smartbench/mainboard/fabrication_outputs/iCE40hxk4_dev_board.csv

Reference | Quantity | Identifier | Package | Value | Tolerance | Voltage | Current | Power | PN | MPN | Dielectric | Type | VDC | Current Max. | Irange | Vref | Impedance 100MHz | If | Vf | Datashet
R101;R704;R708;R1108;R1110;R1107;R1109;R1106;R1105;R207;R201;R209;R210;R301;R302;R303;R304;R305;R306 | 19 |  |  | 10K |  |  |  |  |  | RT0603DRE0710KL
J101;J601;J602 | 3 |  |  | CONN_01X02
J104;J103 | 2 |  |  | CONN_COAXIAL |  |  |  |  |  | 73100-0105
J102 | 1 |  |  | KobiConn_161-3507_Jack_3.5mm |  |  |  |  |  | KobiConn_161-3507
U301 | 1 |  |  | iCE40-HX4K-TQ144 |  |  |  |  |  | iCE40-HX4K-TQ144
C510;C509;C502;C501;C503;C504;C505;C506;C507;C508;C608;C601;C603;C606;C612;C614;C616;C619;C621;C623;C625;C627;C629;C631;C633;C635;C605;C618;C905;C1003;C1011;C1005;C1006;C1002;C1010;C1018;C1102;C1101;C401;C402;C403;C404;C405;C407;C206;C204;C208;C216;C217;C218;C219;C220;C221;C222;C223;C224;C201;C209;C313;C305;C307;C309;C311;C308;C314;C316;C301 | 67 |  |  | 100nF |  |  |  |  |  | C0603C104K3RACTU | X7R | Ceramic | 25V
U501 | 1 |  |  | AS4C1M16S |  |  |  |  |  | AS4C1M16S
C620;C610;C901;C902 | 4 |  |  | 10uF |  |  |  |  |  | GRM188R60J106ME47J | X5R | Ceramic | 6V3
C602;C604;C607;C609;C611;C613;C615;C617;C622;C624;C626;C628;C630;C632;C634;C636;C906;C904;C903;C303;C306 | 21 |  |  | 1uF |  |  |  |  |  | GRM188R61C105KA93D | X5R | Ceramic | 16V
Xtal401;Xtal201 | 2 |  |  | LFSPXO019966 |  |  |  |  |  | LFSPXO019966
SW1101 | 1 |  |  | SW_Push
J1101 | 1 |  |  | CONN_01X25
C907;C1012;C1004;C1008;C1007;C1001;C1009;C1013;C1014;C1015;C1017;C1016;C315;C302;C304;C317 | 16 |  |  | 10uF |  |  |  |  |  | TAJA106K016TNJ |  | Tantalum | 16V
U903 | 1 |  |  | MIC5270 |  |  |  |  |  | MIC5270
U902 | 1 |  |  | TCR2EF13 |  |  |  |  |  | TCR2EF13
U901 | 1 |  |  | LM2776DBVR |  |  |  |  |  | LM2776DBVR
C213;C215;C207;C205 | 4 |  |  | 4.7uF |  |  |  |  |  | TAJA475K016UNJ |  | Tantalum | 16V |  |  |  |  |  |  | http://www.mouser.com/ds/2/40/TAJ_AUTO-783622-1093304.pdf
R211 | 1 |  |  | 12K |  |  |  |  |  | RC0603FR-0712KL
U204 | 1 |  |  | MIC5355/6-xYMME |  |  |  |  |  | MIC5355/6-xYMME
U203 | 1 |  |  | 93LC56BT-I/O |  |  |  |  |  | 93LC56BT-I/O
U201 | 1 |  |  | MIC2005A-2YM5 |  |  |  |  |  | MIC2005A-2YM5
D401;D402;D403;D404;D405;D406;D407;D408;D202;D204 | 10 |  |  | GREEN |  |  |  |  |  | APTD1608LCGCK |  |  |  |  |  |  |  | 2mA | 1.9V
C202;C203;C312;C310 | 4 |  |  | 10nF |  |  |  |  |  | C0603C103K5RECTU | X7R |  | 50V
U1002;U1001 | 2 |  |  | ADC1175 |  |  |  |  |  | ADC1175CIMTCX/NOPB
D1005;D1004 | 2 |  |  | D_Schottky_BAT54-7-F |  |  |  |  |  | BAT54-7-F
C211;C212;C210 | 3 |  |  | 2.2uF |  |  |  |  |  | GRM21BR71A225KA01K | X7R | Ceramic | 10V
R401;R402;R403;R404;R405;R406;R407;R408 | 8 |  |  | 680R |  |  |  |  |  | RC0603FR-07680RL
D1002 | 1 |  |  | LM4041EIM3-1.2/NOPB |  |  |  |  |  | LM4041EIM3-1.2/NOPB |  |  |  |  | ?mA < I < ?mA | 1.225V
D1001;D1003 | 2 |  |  | LM4040DYM3-2.5-TR |  |  |  |  |  | LM4040DYM3-2.5-TR |  |  |  |  | 65uA < I < 15mA | 2.5V
R1004;R1001 | 2 |  |  | 50R |  |  |  |  |  | CRCW060350R0FKEA
R1008;R1009;R1006;R1007;R1113;R1116 | 6 |  |  | 4K7 |  |  |  |  |  | RC0603FR-074K7L
L1002;L1001;L1003;L1004;L1005;L1007;L1006 | 7 |  |  | L_BLM18AG121SN1D |  |  |  |  |  | BLM18AG121SN1D |  |  |  |  |  |  | 75
R1112;R1111 | 2 |  |  | 330R |  |  |  |  |  | RC0603FR-07330RL
R309;R310;R311;R312;R313;R314;R315;R316;R317;R318;R319;R320;R321;R322;R827;R830;R1118;R1115;R212 | 19 |  |  | 1K |  |  |  |  |  | RC0603FR-071KL
R1114;R1117 | 2 |  |  | 1K2 |  |  |  |  |  | RC0603FR-071K2L
L201;L204;L203;L202 | 4 |  |  | L_BLM18BA750SZ1D |  |  |  |  |  | BLM18AG121SN1D |  |  |  |  |  |  | 75
C703;C706 | 2 |  |  | 22pF |  |  |  |  |  | 06031U220FAT2A | C0G | Ceramic | 100V
C705;C708 | 2 |  |  | 5-20pF |  |  |  |  |  | GKG20015
R701;R705 | 2 |  |  | 13K |  |  |  |  |  | RC0603FR-0713KL
R703;R707 | 2 |  |  | 89K8 |  |  |  |  |  | RT0603DRE0789K8L
C701;C702 | 2 |  |  | 100pF |  |  |  |  |  | VJ0603A101JXACW1BC | C0G | Ceramic | 50V
C704;C707 | 2 |  |  | 1-3pF |  |  |  |  |  | GKG3R015
C709;C711 | 2 |  |  | 180p |  |  |  |  |  | VJ0603A181FXXPW1BC | C0G | Ceramic | 25V
C710;C712 | 2 |  |  | 1800p |  |  |  |  |  | GCM1885C1H182FA16D | C0G | Ceramic | 50V
D701;D702;D1007;D1006 | 4 |  |  | D_Schottky_BAT54S-7-F |  |  |  |  |  | BAT54S-7-F
U702;U701 | 2 |  |  | CPC1017N |  |  |  |  |  | CPC1017N
U703;U704;U801;U802 | 4 |  |  | CD4051BM96 |  |  |  |  |  | CD4051BM96
R702;R706 | 2 |  |  | 887K |  |  |  |  |  | RC0603FR-07887KL
R802;R804;R1101;R1102 | 4 |  |  | Let it open
D203 | 1 |  |  | RED |  |  |  |  |  | APTD1608LSURCK |  |  |  |  |  |  |  | 2mA | 1.75V
R202;R205;R204 | 3 |  |  | 1K5 |  |  |  |  |  | CRCW06031K50JNEA
U302 | 1 |  |  | 25LC_EEPROM |  |  |  |  |  | 25LC_EEPROM
U1106;U1101;U1105;U1102 | 4 |  |  | MIC7300 |  |  |  |  |  | MIC7300YM5-TR
U1104 | 1 |  |  | MCP4716 |  |  |  |  |  | MCP4716A0-E/CH
U205 | 1 |  |  | FT2232H |  |  |  |  |  | FT2232H
R710;R709;R803;R801;R1002;R1005;R1103;R1104;R213;R214;R215;R216;R217;R218;R219;R220;R221;R222;R223;R224;R225;R226;R227;R228;R229;R230;R231 | 27 |  |  | 0R |  |  |  |  |  | RC1206JR-070RL |  |  |  | 2A
C714;C713;R833;R837;R834;R838;R835;R839;R836;R840 | 10 |  |  | Not used
R1121;R1122 | 2 |  |  | 62K |  |  |  |  |  | RC0603FR-0762KL
R1119;R1120 | 2 |  |  | 6K8 |  |  |  |  |  | RC0603FR-076K8L
J1005 | 1 |  |  | USB_EXT
C214 | 1 |  |  | 4.7uF |  |  |  |  |  | GRM21BR71C475KE51L | X7R | Ceramic | 16V
J405;J406;J402;J401;J404;J403;J502;J501;J603;J605;J604;J706;J705;J703;J704;J701;J702;J808;J807;J805;J806;J804;J803;J802;J801;J810;J809;J1001;J1002;J1003;J1004 | 31 |  |  | Testpoint
U1103 | 1 |  |  | MCP4716 |  |  |  |  |  | MCP4716A1-E/CH
D301 | 1 |  |  | D_BAS21,215 |  |  |  |  |  | BAS21,215
U803 | 1 |  |  | CLC4007 |  |  |  |  |  | CLC4007
R805;R806;R807;R808;R1011;R1010 | 6 |  |  | 470R |  |  |  |  |  | RC0603FR-07470RL
R811;R815;R817;R812;R818;R820;R1013;R1012;R1003 | 9 |  |  | 220R |  |  |  |  |  | RC0603JR-07220RL
R821;R823;R824;R826;R307;R308 | 6 |  |  | 100R |  |  |  |  |  | RC0603FR-07100RL
R809;R813;R816;R822;R810;R814;R819;R825 | 8 |  |  | 1K8 |  |  |  |  |  | RC0603FR-071K8L
R828;R831 | 2 |  |  | 47K |  |  |  |  |  | RC0603FR-0747KL
R829;R832;R208 | 3 |  |  | 2K2 |  |  |  |  |  | RC0603FR-072K2L
D201;D208 | 2 |  |  | D_Schottky_CDBURT0530LL-HF |  |  |  |  |  | CDBURT0530LL-HF
J202 | 1 |  |  | USB_OTG
