smartbench/mainboard/fabrication_outputs/iCE40hxk4_dev_board.xlsx

 |  |  |  |  |  |  | Board Qty: | 5
 |  |  |  |  |  |  | Total Cost: | $265.44 |  |  |  | $333.19 |  |  |  |  |  | $164.89 |  |  |  |  |  | $337.89 |  |  |  |  |  | $194.54 |  |  |  |  |  | $727.60
 |  |  |  |  |  |  | Unit Cost: | $53.09
Global Part Info |  |  |  |  |  |  |  |  | Digi-Key |  |  |  |  |  | Farnell |  |  |  |  |  | Mouser |  |  |  |  |  | Newark |  |  |  |  |  | Rs Components
Refs | Value | Desc | Footprint | Manf | Manf# | Qty | Unit$ | Ext$ | Avail | Purch | Unit$ | Ext$ | Cat# | Doc | Avail | Purch | Unit$ | Ext$ | Cat# | Doc | Avail | Purch | Unit$ | Ext$ | Cat# | Doc | Avail | Purch | Unit$ | Ext$ | Cat# | Doc | Avail | Purch | Unit$ | Ext$ | Cat# | Doc
R213-R231 | 0R |  | Resistors_SMD:R_0603_HandSoldering |  | RC1206JR-070RL | 95 | $0.01 | $1.25 | 8491390 |  | $0.01 | $1.25 | 311-0.0ERCT-ND | Link (http://www.digikey.com/product-detail/en/yageo/RC1206JR-070RL/311-0.0ERCT-ND/732131) |  |  | $0.01 | $1.38 | 9240276 | Link (http://it.farnell.com/yageo-phycomp/rc1206jr-070rl/res-film-spesso-0r-5-0-25w-1206/dp/9240276) | 1140411 |  | $0.02 | $1.71 | 603-RC1206JR-070RL | Link (http://www.mouser.com/Search/Refine.aspx?Keyword=RC1206JR-070RL%20) |  |  | $0.02 | $1.52 | 68R0297 | Link (http://www.newark.com/yageo/rc1206jr-070rl/res-thick-film-0r-0-25w-1206/dp/68R0297)
R828,R831 | 47K |  | Resistors_SMD:R_0603_HandSoldering |  | RC0603FR-0747KL | 10 | $0.01 | $0.09 | 3662752 |  | $0.01 | $0.15 | 311-47.0KHRCT-ND | Link (http://www.digikey.com/product-detail/en/yageo/RC0603FR-0747KL/311-47.0KHRCT-ND/730200) |  |  | $0.01 | $0.09 | 9238689 | Link (http://it.farnell.com/yageo-phycomp/rc0603fr-0747kl/res-film-spesso-47k-1-0-1w-0603/dp/9238689) | 379387 |  | $0.01 | $0.11 | 603-RC0603FR-0747KL | Link (http://www.mouser.com/Search/Refine.aspx?Keyword=RC0603FR-0747KL%20) |  |  | $0.01 | $0.11 | 26M6759 | Link (http://www.newark.com/yageo-phycomp/rc0603fr-0747kl/res-thick-film-47k-1-0-1w-0603/dp/26M6759)
C601,C603,C605,C606,C608,C612,C614,C616,C618,C619,C621,C623,C625,C627,C629,C631,C633,C635,C905,C1002,C1003,C1005,C1006,C1010,C1011,C1018,C1101,C1102 | 100nF |  | Capacitors_SMD:C_0603_HandSoldering |  | C0603C104K3RACTU | 140 | $0.01 | $1.82 | 4778400 |  | $0.01 | $1.90 | 399-1281-1-ND | Link (http://www.digikey.com/product-detail/en/kemet/C0603C104K3RACTU/399-1281-1-ND/416057) |  |  | $0.02 | $2.44 | 1650835 | Link (http://it.farnell.com/kemet/c0603c104k3ractu/condensatore-mlcc-x7r-100nf-25v/dp/1650835) | 492157 |  | $0.01 | $1.82 | 80-C0603C104K3R | Link (http://www.mouser.com/ProductDetail/KEMET/C0603C104K3RACTU/?qs=sGAEpiMZZMs0AnBnWHyRQFqPnX0Olvco4w4aWMbN5gs%3D) |  |  | $0.01 | $1.82 | 64K2837 | Link (http://www.newark.com/kemet/c0603c104k3ractu/ceramic-capacitor-0-1uf-25v-x7r/dp/64K2837) | 2500 |  | $0.02 | $2.53 | 147-538 | Link (http://it.rs-online.com/web/c/?searchTerm=C0603C104K3RACTU%20)
R1111,R1112 | 330R |  | Resistors_SMD:R_0603_HandSoldering |  | RC0603FR-07330RL | 10 | $0.002 | $0.02 | 1578144 |  | $0.01 | $0.15 | 311-330HRCT-ND | Link (http://www.digikey.com/product-detail/en/yageo/RC0603FR-07330RL/311-330HRCT-ND/730109) |  |  | $0.01 | $0.08 | 9238425 | Link (http://it.farnell.com/yageo-phycomp/rc0603fr-07330rl/res-film-spesso-330r-1-0-1w-0603/dp/9238425) | 187203 |  | $0.01 | $0.11 | 603-RC0603FR-07330RL | Link (http://www.mouser.com/Search/Refine.aspx?Keyword=RC0603FR-07330RL%20) |  |  | $0.002 | $0.02 | 75X0150 | Link (http://www.newark.com/yageo-phycomp/rc0603fr-07330rl/surface-mount-chip-resistor-thick/dp/75X0150)
U205 | FT2232H |  | Housings_QFP:LQFP-64_10x10mm_Pitch0.5mm |  | FT2232HL | 5 | $6.24 | $31.20 | 35362 |  | $6.71 | $33.55 | 768-1024-1-ND | Link (http://www.digikey.com/product-detail/en/ftdi-future-technology-devices-international-ltd/FT2232HL-REEL/768-1024-1-ND/1986057) |  |  | $7.31 | $36.57 | 1697461 | Link (http://it.farnell.com/ftdi/ft2232hl-r/usb-uart-fifo-2232-doppio-64lqfp/dp/1697461) | 1526 |  | $6.73 | $33.65 | 895-FT2232HL-TRAY | Link (http://www.mouser.com/ProductDetail/FTDI/FT2232HL-TRAY/?qs=sGAEpiMZZMsgaWLkU6GBSK8bHXjqNrK1) |  |  | $7.74 | $38.70 | 80P4235 | Link (http://www.newark.com/webapp/wcs/stores/servlet/Search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) | 25 |  | $6.24 | $31.20 | 687-7720 | Link (http://it.rs-online.com/web/c/?searchTerm=FT2232HL%20)
C610,C620,C901,C902 | 10uF |  | Capacitors_SMD:C_0603_HandSoldering |  | GRM188R60J106ME47J | 20 | $0.05 | $1.08 |  |  | $0.12 | $2.46 | 490-6405-1-ND | Link (http://www.digikey.com/product-detail/en/murata-electronics-north-america/GRM188R60J106ME47J/490-6405-1-ND/3845602) |  |  | $0.07 | $1.35 | 2611921 | Link (http://it.farnell.com/murata/grm188r60j106me47j/cond-mlcc-x5r-10uf-6-3v-0603/dp/2611921) | 36345 |  | $0.10 | $2.10 | 81-GRM188R60J106ME7J | Link (http://www.mouser.com/Search/Refine.aspx?Keyword=GRM188R60J106ME47J%20) |  |  | $0.10 | $2.10 | 96Y9254 | Link (http://www.newark.com/webapp/wcs/stores/servlet/Search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) | 1000 |  | $0.05 | $1.08 | 815-1355 | Link (http://it.rs-online.com/web/c/?searchTerm=GRM188R60J106ME47J%20)
R202,R204,R205 | 1K5 |  | Resistors_SMD:R_0603_HandSoldering |  | CRCW06031K50JNEA | 15 | $0.02 | $0.31 |  |  | $0.03 | $0.39 | 541-1.5KGCT-ND | Link (http://www.digikey.com/product-detail/en/vishay-dale/CRCW06031K50JNEA/541-1.5KGCT-ND/1179373) |  |  | $0.02 | $0.31 | 2616745 | Link (http://it.farnell.com/vishay/crcw06031k50jnea/res-pell-spessa-aec-q200-1k5-0603/dp/2616745) | 213515 |  | $0.04 | $0.60 | 71-CRCW0603J-1.5K-E3 | Link (http://www.mouser.com/ProductDetail/Vishay/CRCW06031K50JNEA/?qs=sGAEpiMZZMu61qfTUdNhG82Z6Ry1C7AqqcTNlUx7YuQ%3D) |  |  | $0.10 | $1.50 | 59M6753 | Link (http://www.newark.com/vishay/crcw06031k50jnea/res-thick-film-1k5-5-0-1w-0603/dp/59M6753) |  |  |  |  | 830-6668 | Link (http://it.rs-online.com/web/c/?searchTerm=CRCW06031K50JNEA%20)
D1001,D1003 | LM4040DYM3-2.5-TR |  | TO_SOT_Packages_SMD:SOT-23 |  | LM4040DYM3-2.5-TR | 10 | $0.21 | $2.09 | 14820 |  | $0.30 | $3.00 | 576-1047-1-ND | Link (http://www.digikey.com/product-detail/en/microchip-technology/LM4040DYM3-2.5-TR/576-1047-1-ND/771818) |  |  | $0.21 | $2.09 | 2509865 | Link (http://it.farnell.com/microchip/lm4040dym3-2-5-tr/voltage-ref-shunt-2-5v-sot-23/dp/2509865) | 5263 |  | $0.29 | $2.91 | 998-LM4040DYM3-2.5TR | Link (http://www.mouser.com/Search/Refine.aspx?Keyword=LM4040DYM3-2.5-TR%20) |  |  | $0.30 | $3.03 | 91Y4892 | Link (http://www.newark.com/webapp/wcs/stores/servlet/Search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)
R1119,R1120 | 6K8 |  | Resistors_SMD:R_0603_HandSoldering |  | RC0603FR-076K8L | 10 | $0.01 | $0.09 | 1237938 |  | $0.01 | $0.15 | 311-6.80KHRCT-ND | Link (http://www.digikey.com/product-detail/en/yageo/RC0603FR-076K8L/311-6.80KHRCT-ND/730270) |  |  | $0.01 | $0.09 | 9238581 | Link (http://it.farnell.com/yageo-phycomp/rc0603fr-076k8l/res-film-spesso-6k8-1-0-1w-0603/dp/9238581) | 207781 |  | $0.01 | $0.11 | 603-RC0603FR-076K8L | Link (http://www.mouser.com/Search/Refine.aspx?Keyword=RC0603FR-076K8L%20) |  |  | $0.01 | $0.14 | 68R0109 | Link (http://www.newark.com/yageo/rc0603fr-076k8l/res-thick-film-6k8-1-0-1w-0603/dp/68R0109)
U201 | MIC2005A-2YM5 |  | TO_SOT_Packages_SMD:SOT-23-5_HandSoldering |  | MIC2005A-2YM5 | 5 | $0.21 | $1.05 | 4176 |  | $0.29 | $1.45 | 576-3464-1-ND | Link (http://www.digikey.com/product-detail/en/microchip-technology/MIC2005A-2YM5-TR/576-3464-1-ND/2062464) |  |  | $0.21 | $1.05 | 2431853 | Link (http://it.farnell.com/micrel-semiconductor/mic2005a-2ym5-tr/limitaz-corrente-attiva-alta-e/dp/2431853) | 3448 |  | $0.30 | $1.50 | 998-MIC2005A-2YM5TR | Link (http://www.mouser.com/Search/Refine.aspx?Keyword=MIC2005A-2YM5%20) |  |  | $0.22 | $1.08 | 11AC9662 | Link (http://www.newark.com/webapp/wcs/stores/servlet/Search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) | 640 |  | $0.30 | $1.49 | 727-5113 | Link (http://it.rs-online.com/web/c/?searchTerm=MIC2005A-2YM5%20)
C704,C707 | 1-3pF |  | Capacitors_THT:CP_Radial_Tantal_D6.0mm_P5.00mm |  | GKG3R015 | 10 | $0.66 | $6.55 | 1423 |  | $0.66 | $6.55 | SG9031-ND | Link (http://www.digikey.com/scripts/DkSearch/dksus.dll?WT.z_header=search_go&lang=en&keywords=GKG3R015%20) |  |  |  |  |  |  | 113 |  | $0.77 | $7.65 | 659-GKG3R015 | Link (http://www.mouser.com/Search/Refine.aspx?Keyword=GKG3R015%20)
C701,C702 | 100pF |  | Capacitors_SMD:C_0603_HandSoldering |  | GRM1885C1H101GA01J | 10 | $0.05 | $0.52 | 24146 |  | $0.10 | $1.05 | 490-10703-1-ND | Link (http://www.digikey.com/product-detail/en/murata-electronics-north-america/GRM1885C1H101GA01J/490-10703-1-ND/5251397) |  |  |  |  |  |  | 14678 |  | $0.05 | $0.52 | 81-GRM1885C1H101GA1J | Link (http://www.mouser.com/Search/Refine.aspx?Keyword=GRM1885C1H101GA01J%20)
L1001-L1007 | L_BLM18AG121SN1D |  | Inductors_SMD:L_0603_HandSoldering |  | BLM18AG121SN1D | 35 | $0.03 | $1.12 | 595822 |  | $0.07 | $2.52 | 490-1011-1-ND | Link (http://www.digikey.com/product-detail/en/murata-electronics-north-america/BLM18AG121SN1D/490-1011-1-ND/584459) |  |  | $0.03 | $1.12 | 1515672 | Link (http://it.farnell.com/murata/blm18ag121sn1d/ferrite-bead-0-18ohm-500ma-0603/dp/1515672) | 111537 |  | $0.06 | $2.24 | 81-BLM11A121S | Link (http://www.mouser.com/Search/Refine.aspx?Keyword=BLM18AG121SN1D%20) |  |  | $0.05 | $1.89 | 73M9051 | Link (http://www.newark.com/webapp/wcs/stores/servlet/Search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) | 720 |  | $0.08 | $2.68 | 202-3550 | Link (http://it.rs-online.com/web/c/?searchTerm=BLM18AG121SN1D%20)
C1001,C1004,C1007-C1009,C1012-C1017 | 10uF |  | Capacitors_SMD:C_1206_HandSoldering |  | TAJA106K016TNJ | 55 | $0.10 | $5.67 |  |  | $0.32 | $17.71 | 478-10744-1-ND | Link (http://www.digikey.com/product-detail/en/avx-corporation/TAJA106K016TNJ/478-10744-1-ND/7536607) |  |  |  |  |  |  | 1756 |  | $0.10 | $5.67 | 581-TAJA106K016TNJ | Link (http://www.mouser.com/Search/Refine.aspx?Keyword=TAJA106K016TNJ%20) |  |  | $0.20 | $10.78 | 60R5827 | Link (http://www.newark.com/avx/taja106k016rnj/tantalum-capacitor-10uf-16v-3/dp/60R5827?rpsku=rel3%3ATAJA106K016TNJ)
SW1101 | SW_Push |  | Buttons_Switches_THT:SW_PUSH_6mm_h4.3mm |  | 1301.9309 | 5 | $0.25 | $1.24 |  |  | $0.35 | $1.75 | 486-3464-ND | Link (http://www.digikey.com/scripts/DkSearch/dksus.dll?WT.z_header=search_go&lang=en) |  |  |  |  | 1217779 | Link (http://it.farnell.com/webapp/wcs/stores/servlet/Search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) | 1478 |  | $0.25 | $1.24 | 693-1301.9309 | Link (http://www.mouser.com/Search/Refine.aspx?Keyword=1301.9309%20) |  |  | $0.36 | $1.80 | 32C4748 | Link (http://www.newark.com/webapp/wcs/stores/servlet/Search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)
J103,J104 | CONN_COAXIAL |  | library:BNC_1-1337543-0 |  | 1-1337543-0 | 10 | $1.32 | $13.20 | 3053 |  | $1.65 | $16.54 | A97553-ND | Link (http://www.digikey.com/scripts/DkSearch/dksus.dll?WT.z_header=search_go&lang=en) |  |  | $1.50 | $14.99 | 1020955 | Link (http://it.farnell.com/webapp/wcs/stores/servlet/Search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) | 3595 |  | $1.73 | $17.30 | 571-1-1337543-0 | Link (http://www.mouser.com/Search/Refine.aspx?Keyword=1-1337543-0%20) |  |  | $1.32 | $13.20 | 63K9785 | Link (http://www.newark.com/webapp/wcs/stores/servlet/Search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) |  |  | $2.00 | $19.98 | 512-1225 | Link (http://it.rs-online.com/web/c/?searchTerm=1-1337543-0%20)
D1004,D1005 | D_Schottky_BAT54-7-F |  | Diodes_SMD:D_SOT-23_ANK |  | BAT54-7-F | 10 | $0.03 | $0.27 | 222415 |  | $0.15 | $1.49 | BAT54-FDICT-ND | Link (http://www.digikey.com/product-detail/en/diodes-incorporated/BAT54-7-F/BAT54-FDICT-ND/717819) |  |  | $0.03 | $0.27 | 2306003 | Link (http://it.farnell.com/multicomp/bat54-7-f/diode-ultrafast-recovery-200ma/dp/2306003) | 67684 |  | $0.14 | $1.43 | 621-BAT54-F | Link (http://www.mouser.com/Search/Refine.aspx?Keyword=BAT54-7-F%20) |  |  | $0.12 | $1.19 | 65W8455 | Link (http://www.newark.com/multicomp/bat54-7-f/diode-ultrafast-recovery-200ma/dp/65W8455) |  |  | $0.07 | $0.66 | 738-4829 | Link (http://it.rs-online.com/web/p/diodi-rettificatori-e-schottky/7384829/)
C205,C207,C213,C215 | 4.7uF |  | Capacitors_SMD:C_1206_HandSoldering |  | TMCMA1A475MTRF | 20 | $0.20 | $4.02 |  |  |  |  |  |  |  |  |  |  |  |  | 1949 |  | $0.20 | $4.02 | 74-TMCMA1A475MTRF | Link (http://www.mouser.com/Search/Refine.aspx?Keyword=TMCMA1A475MTRF%20)
R827,R830,R1115,R1118 | 1K |  | Resistors_SMD:R_0603_HandSoldering |  | RC0603FR-071KL | 20 | $0.01 | $0.17 | 8252962 |  | $0.01 | $0.30 | 311-1.00KHRCT-ND | Link (http://www.digikey.com/product-detail/en/yageo/RC0603FR-071KL/311-1.00KHRCT-ND/729790) |  |  | $0.01 | $0.17 | 9238484 | Link (http://it.farnell.com/yageo-phycomp/rc0603fr-071kl/res-film-spesso-1k-1-0-1w-0603/dp/9238484) | 1827498 |  | $0.01 | $0.22 | 603-RC0603FR-071KL | Link (http://www.mouser.com/Search/Refine.aspx?Keyword=RC0603FR-071KL%20) |  |  | $0.01 | $0.28 | 68R0042 | Link (http://www.newark.com/yageo/rc0603fr-071kl/res-thick-film-1k-1-0-1w-0603/dp/68R0042)
R809,R810,R813,R814,R816,R819,R822,R825 | 1K8 |  | Resistors_SMD:R_0603_HandSoldering |  | RC0603FR-071K8L | 40 | $0.002 | $0.08 | 592750 |  | $0.01 | $0.60 | 311-1.80KHRCT-ND | Link (http://www.digikey.com/product-detail/en/yageo/RC0603FR-071K8L/311-1.80KHRCT-ND/729821) |  |  | $0.01 | $0.28 | 9238514 | Link (http://it.farnell.com/yageo-phycomp/rc0603fr-071k8l/res-film-spesso-1k8-1-0-1w-0603/dp/9238514) | 4594 |  | $0.01 | $0.44 | 603-RC0603FR-071K8L | Link (http://www.mouser.com/ProductDetail/Yageo/RC0603FR-071K8L/?qs=sGAEpiMZZMu61qfTUdNhG5eFuApKbqVdVKGQIhGipHw%3D) |  |  | $0.002 | $0.08 | 12AC2123 | Link (http://www.newark.com/yageo-phycomp/rc0603fr-071k8l/res-thick-film-1k8-1-0-1w-0603/dp/12AC2123)
R805-R808,R1010,R1011 | 470R |  | Resistors_SMD:R_0603_HandSoldering |  | RC0603FR-07470RL | 30 | $0.0044646 | $0.13 | 1227827 |  | $0.01 | $0.45 | 311-470HRCT-ND | Link (http://www.digikey.com/product-detail/en/yageo/RC0603FR-07470RL/311-470HRCT-ND/730203) |  |  | $0.0044646 | $0.13 | 2413707 | Link (http://it.farnell.com/yageo/rc0603fr-07470rl/res-thick-film-470r-1-0-1w-0603/dp/2413707) | 394001 |  | $0.01 | $0.33 | 603-RC0603FR-07470RL | Link (http://www.mouser.com/Search/Refine.aspx?Keyword=RC0603FR-07470RL%20) |  |  | $0.01 | $0.30 | 68R0099 | Link (http://www.newark.com/yageo/rc0603fr-07470rl/res-thick-film-470r-1-0-1w-0603/dp/68R0099)
R1121,R1122 | 62K |  | Resistors_SMD:R_0603_HandSoldering |  | RC0603FR-0762KL | 10 | $0.01 | $0.05 | 95679 |  | $0.01 | $0.15 | 311-62.0KHRCT-ND | Link (http://www.digikey.com/product-detail/en/yageo/RC0603FR-0762KL/311-62.0KHRCT-ND/730283) |  |  |  |  |  |  | 7853 |  | $0.01 | $0.11 | 603-RC0603FR-0762KL | Link (http://www.mouser.com/ProductDetail/Yageo/RC0603FR-0762KL/?qs=sGAEpiMZZMu61qfTUdNhG6gKAQVNBKOo1YUM907byVY%3D) |  |  | $0.01 | $0.05 | 66R2519 | Link (http://www.newark.com/webapp/wcs/stores/servlet/Search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)
U1104 | MCP4716 |  | TO_SOT_Packages_SMD:SOT-23-6 |  | MCP4716A0T-E/CH | 5 | $0.75 | $3.77 | 1656 |  | $0.86 | $4.30 | MCP4716A0T-E/CHCT-ND | Link (http://www.digikey.com/product-detail/en/microchip-technology/MCP4716A0T-E-CH/MCP4716A0T-E-CHCT-ND/2684987) |  |  | $0.81 | $4.06 | 1925045 | Link (http://it.farnell.com/microchip/mcp4716a0t-e-ch/dac-10bit-nv-eep-i2c-sot-23-6/dp/1925045) | 5423 |  | $0.90 | $4.51 | 579-MCP4716A0TECH | Link (http://www.mouser.com/Search/Refine.aspx?Keyword=MCP4716A0T-E%2FCH%20) |  |  | $0.86 | $4.29 | 58T2010 | Link (http://www.newark.com/webapp/wcs/stores/servlet/Search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) |  |  | $0.75 | $3.77 | 738-7124 | Link (http://it.rs-online.com/web/p/dac-per-impieghi-generali/7387124/)
U1103 | MCP4716 |  | TO_SOT_Packages_SMD:SOT-23-6 |  | MCP4716A1T-E/CH | 5 | $0.75 | $3.75 | 2978 |  | $0.86 | $4.30 | MCP4716A1T-E/CHCT-ND | Link (http://www.digikey.com/product-detail/en/microchip-technology/MCP4716A1T-E-CH/MCP4716A1T-E-CHCT-ND/7065581) |  |  |  |  |  |  | 3091 |  | $0.90 | $4.51 | 579-MCP4716A1TECH | Link (http://www.mouser.com/Search/Refine.aspx?Keyword=MCP4716A1T-E%2FCH%20) |  |  |  |  |  |  |  |  | $0.75 | $3.75 | 823-0959 | Link (http://it.rs-online.com/web/c/?searchTerm=MCP4716A1T-E%2FCH%20)
U901 | LM2776DBVR |  | TO_SOT_Packages_SMD:SOT-23-6 |  | LM2776DBVR | 5 | $0.43 | $2.14 | 6577 |  | $1.10 | $5.50 | 296-43957-1-ND | Link (http://www.digikey.com/product-detail/en/texas-instruments/LM2776DBVR/296-43957-1-ND/5973203) |  |  | $1.34 | $6.70 | 2498456 | Link (http://it.farnell.com/webapp/wcs/stores/servlet/Search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) | 9818 |  | $1.06 | $5.30 | 595-LM2776DBVR | Link (http://www.mouser.com/ProductDetail/Texas-Instruments/LM2776DBVR/) |  |  | $0.43 | $2.14 | 53Y0672 | Link (http://www.newark.com/webapp/wcs/stores/servlet/Search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)
D201,D208 | D_Schottky_CDBURT0530LL-HF |  | Diodes_SMD:D_0603 |  | CDBURT0530LL-HF | 10 | $0.27 | $2.67 | 6290 |  | $0.33 | $3.31 | 641-1520-1-ND | Link (http://www.digikey.com/product-detail/en/comchip-technology/CDBURT0530LL-HF/641-1520-1-ND/4835670) |  |  |  |  |  |  | 2607 |  | $0.27 | $2.67 | 750-CDBURT0530LL-HF | Link (http://www.mouser.com/Search/Refine.aspx?Keyword=CDBURT0530LL-HF%20)
J1005 | USB_EXT |  | library:USB_Micro-B_47642-0001 |  | 47642-0001 | 5 | $0.56 | $2.80 | 13836 |  | $0.81 | $4.05 | WM1398CT-ND | Link (http://www.digikey.com/product-detail/en/molex-llc/0476420001/WM1398CT-ND/2350884) |  |  | $0.56 | $2.80 | 2396171 | Link (http://it.farnell.com/webapp/wcs/stores/servlet/Search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) | 8115 |  | $0.68 | $3.41 | 538-47642-0001 | Link (http://www.mouser.com/Search/Refine.aspx?Keyword=47642-0001%20) |  |  | $0.68 | $3.40 | 78R2131 | Link (http://www.newark.com/webapp/wcs/stores/servlet/Search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) |  |  | $0.61 | $3.05 | 896-7419 | Link (http://it.rs-online.com/web/c/?searchTerm=47642-0001%20)
C302,C304,C315,C317 | 10uF |  | Capacitors_SMD:C_1206_HandSoldering |  | TAJA106K016TNJ | 20 | $0.12 | $2.40 |  |  | $0.32 | $6.44 | 478-10744-1-ND | Link (http://www.digikey.com/product-detail/en/avx-corporation/TAJA106K016TNJ/478-10744-1-ND/7536607) |  |  |  |  |  |  | 1756 |  | $0.12 | $2.40 | 581-TAJA106K016TNJ | Link (http://www.mouser.com/Search/Refine.aspx?Keyword=TAJA106K016TNJ%20) |  |  | $0.25 | $5.08 | 60R5827 | Link (http://www.newark.com/avx/taja106k016rnj/tantalum-capacitor-10uf-16v-3/dp/60R5827?rpsku=rel3%3ATAJA106K016TNJ)
D203 | RED |  | LEDs:LED_0603 |  | APTD1608LSURCK | 5 | $0.32 | $1.60 | 1780 |  | $0.41 | $2.05 | 754-2038-1-ND | Link (http://www.digikey.com/product-detail/en/kingbright/APTD1608LSURCK/754-2038-1-ND/7043092) |  |  |  |  |  |  | 3770 |  | $0.32 | $1.60 | 604-APTD1608LSURCK | Link (http://www.mouser.com/Search/Refine.aspx?Keyword=APTD1608LSURCK%20)
J102 | Jack Estereo |  | library:KobiConn_161-3509-E_Jack_3.5mm |  | KobiConn_161-3509-E | 5 | $1.05 | $5.25 |  |  |  |  |  |  |  |  |  |  |  |  | 357 |  | $1.05 | $5.25 | 161-3509-E | Link (http://www.mouser.com/Search/Refine.aspx?Keyword=KobiConn_161-3509-E%20)
U902 | TCR2EF13,LM |  | library:SC-74(5-pins) |  | TCR2EF13,LM | 5 | $0.39 | $1.95 | 8309 |  | $0.39 | $1.95 | TCR2EF13LM(CTCT-ND | Link (http://www.digikey.com/product-detail/en/toshiba-semiconductor-and-storage/TCR2EF13,LM(CT/TCR2EF13LM(CTCT-ND/4503319) |  |  |  |  |  |  | 4440 |  | $0.45 | $2.26 | 757-TCR2EF13LM | Link (http://www.mouser.com/ProductDetail/Toshiba/TCR2EF13LM/)
C201,C204,C206,C208,C209,C216-C224,C301,C305,C307-C309,C311,C313,C314,C316,C401-C405,C407,C501-C510 | 100nF |  | Capacitors_SMD:C_0603_HandSoldering |  | C0603C104K3RACTU | 195 | $0.01 | $2.54 | 4778400 |  | $0.01 | $2.65 | 399-1281-1-ND | Link (http://www.digikey.com/product-detail/en/kemet/C0603C104K3RACTU/399-1281-1-ND/416057) |  |  | $0.02 | $3.40 | 1650835 | Link (http://it.farnell.com/kemet/c0603c104k3ractu/condensatore-mlcc-x7r-100nf-25v/dp/1650835) | 492157 |  | $0.01 | $2.54 | 80-C0603C104K3R | Link (http://www.mouser.com/ProductDetail/KEMET/C0603C104K3RACTU/?qs=sGAEpiMZZMs0AnBnWHyRQFqPnX0Olvco4w4aWMbN5gs%3D) |  |  | $0.01 | $2.54 | 64K2837 | Link (http://www.newark.com/kemet/c0603c104k3ractu/ceramic-capacitor-0-1uf-25v-x7r/dp/64K2837) |  |  | $0.02 | $3.52 | 147-538 | Link (http://it.rs-online.com/web/c/?searchTerm=C0603C104K3RACTU%20)
C210-C212 | 2.2uF |  | Capacitors_SMD:C_0805_HandSoldering |  | GRM21BR71A225KA01K | 15 | $0.11 | $1.67 | 5443 |  | $0.13 | $1.94 | 490-11596-1-ND | Link (http://www.digikey.com/product-detail/en/murata-electronics-north-america/GRM21BR71A225KA01K/490-11596-1-ND/5333436) |  |  |  |  |  |  | 11032 |  | $0.11 | $1.67 | 81-GRM21BR71A225KA1K | Link (http://www.mouser.com/Search/Refine.aspx?Keyword=GRM21BR71A225KA01K%20) |  |  |  |  |  |  | 2 |  | $3.16 | $47.36 | 106-757 | Link (http://it.rs-online.com/web/c/?searchTerm=GRM21BR71A225KA01K%20)
C214 | 4.7uF |  | Capacitors_SMD:C_0805_HandSoldering |  | GRM21BR71A475KE51L | 5 | $0.03 | $0.17 |  |  | $0.03 | $0.17 | GRM21BR71A475KE51L-ND | Link (http://www.digikey.com/scripts/DkSearch/dksus.dll?WT.z_header=search_go&lang=en) |  |  |  |  |  |  | 18198 |  | $0.19 | $0.95 | 81-GRM21BR71A475KE1L | Link (http://www.mouser.com/ProductDetail/Murata-Electronics/GRM21BR71A475KE51L/)
U203 | 93LC56BT-I/OT |  | TO_SOT_Packages_SMD:SOT-23-6_Handsoldering |  | 93LC56BT-I/OT | 5 | $0.23 | $1.13 | 26261 |  | $0.28 | $1.40 | 93LC56BT-I/OTCT-ND | Link (http://www.digikey.com/product-detail/en/microchip-technology/93LC56BT-I-OT/93LC56BT-I-OTCT-ND/857632) |  |  | $0.23 | $1.13 | 1556165 | Link (http://it.farnell.com/webapp/wcs/stores/servlet/Search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) | 24213 |  | $0.27 | $1.35 | 579-93LC56BT-I/OT | Link (http://www.mouser.com/Search/Refine.aspx?Keyword=93LC56BT-I%2FOT%20) |  |  | $0.23 | $1.15 | 30H4760 | Link (http://www.newark.com/microchip/93lc56bt-i-ot/serial-eeprom-2kbit-2mhz-sot-23/dp/30H4760) |  |  | $96.20 | $481.01 | 454-343 | Link (http://it.rs-online.com/web/p/memorie-eeprom/0454343/)
U1101,U1102,U1105,U1106 | MIC7300 |  | TO_SOT_Packages_SMD:SOT-23-5 |  | MIC7300YM5-TR | 20 | $0.21 | $4.19 | 4643 |  | $0.29 | $5.80 | 576-1319-1-ND | Link (http://www.digikey.com/product-detail/en/microchip-technology/MIC7300YM5-TR/576-1319-1-ND/771923) |  |  | $0.21 | $4.19 | 2510429 | Link (http://it.farnell.com/microchip/mic7300ym5-tr/op-amp-rr-10v-500khz-0-5v-us-5sot23/dp/2510429) | 27901 |  | $0.28 | $5.62 | 998-MIC7300YM5TR | Link (http://www.mouser.com/Search/Refine.aspx?Keyword=MIC7300YM5-TR%20) |  |  | $0.29 | $5.82 | 72Y5351 | Link (http://www.newark.com/webapp/wcs/stores/servlet/Search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) |  |  | $0.43 | $8.53 | 910-1874 | Link (http://it.rs-online.com/web/p/amplificatori-operazionali/9101874/)
R401-R408 | 680R |  | Resistors_SMD:R_0603_HandSoldering |  | RC0603FR-07680RL | 40 | $0.01 | $0.34 | 1483212 |  | $0.01 | $0.60 | 311-680HRCT-ND | Link (http://www.digikey.com/product-detail/en/yageo/RC0603FR-07680RL/311-680HRCT-ND/730302) |  |  | $0.01 | $0.34 | 9238468 | Link (http://it.farnell.com/yageo-phycomp/rc0603fr-07680rl/res-film-spesso-680r-1-0-1w-0603/dp/9238468) | 378766 |  | $0.01 | $0.44 | 603-RC0603FR-07680RL | Link (http://www.mouser.com/Search/Refine.aspx?Keyword=RC0603FR-07680RL%20) |  |  | $0.01 | $0.40 | 68R0112 | Link (http://www.newark.com/yageo/rc0603fr-07680rl/res-thick-film-680r-1-0-1w-0603/dp/68R0112)
D301 | D_BAS21,215 |  | Diodes_SMD:D_SOT-23_ANK |  | BAS21,215 | 5 | $0.05 | $0.27 | 17057 |  | $0.14 | $0.70 | 1727-2889-1-ND | Link (http://www.digikey.com/product-detail/en/nexperia-usa-inc/BAS21,215/1727-2889-1-ND/763425) |  |  | $0.05 | $0.27 | 8734267 | Link (http://it.farnell.com/nxp/bas21-215/diodo-commutaz-sot-23/dp/8734267) | 72032 |  | $0.14 | $0.70 | 771-BAS21-T/R | Link (http://www.mouser.com/ProductDetail/Nexperia/BAS21215/) |  |  | $0.14 | $0.70 | 75R4934 | Link (http://www.newark.com/nexperia/bas21-215/switching-diode-250v-sot-23/dp/75R4934) | 1400 |  | $0.06 | $0.29 | 738-4803 | Link (http://it.rs-online.com/web/p/diodi-switching/7384803/)
J101,J601,J602 | CONN_01X02 |  | Pin_Headers:Pin_Header_Straight_1x02_Pitch1.27mm |  | M50-3030242 | 15 | $0.56 | $8.32 | 1417 |  | $0.56 | $8.32 | 952-3574-ND | Link (http://www.digikey.com/scripts/DkSearch/dksus.dll?WT.z_header=search_go&lang=en) |  |  |  |  |  |  | 1848 |  | $0.56 | $8.36 | 855-M50-3030242 | Link (http://www.mouser.com/Search/Refine.aspx?Keyword=M50-3030242%20)
C303,C306 | 1uF |  | Capacitors_SMD:C_0603_HandSoldering |  | C0603C105K8PACTU | 10 | $0.02 | $0.21 | 533526 |  | $0.05 | $0.49 | 399-3118-1-ND | Link (http://www.digikey.com/product-detail/en/kemet/C0603C105K8PACTU/399-3118-1-ND/551623) |  |  | $0.02 | $0.22 | 9227776 | Link (http://it.farnell.com/kemet/c0603c105k8pactu/condensatore-mlcc-x5r-1uf-10v/dp/9227776) | 121568 |  | $0.02 | $0.22 | 80-C0603C105K8P | Link (http://www.mouser.com/ProductDetail/KEMET/C0603C105K8PACTU/?qs=sGAEpiMZZMs0AnBnWHyRQFqPnX0OlvcoH0hWHQB3lFc%3D) |  |  | $0.10 | $1.00 | 70K9090 | Link (http://www.newark.com/kemet/c0603c105k8pactu/ceramic-capacitor-1uf-10v-x5r/dp/70K9090) |  |  | $0.02 | $0.21 | 461-2708 | Link (http://it.rs-online.com/web/c/?searchTerm=C0603C105K8PACTU%20)
Xtal201,Xtal401 | LFSPXO019966 |  | Oscillators:Oscillator_SMD_Fordahl_DFAS11-4pin_7.0x5.0mm_HandSoldering |  | LFSPXO019966 | 10 | $0.90 | $9.04 |  |  |  |  |  |  |  |  | $1.37 | $13.71 | 2449423 | Link (http://it.farnell.com/iqd-frequency-products/lfspxo019966/oscillator-12mhz-50pf-smd/dp/2449423) | 875 |  | $0.98 | $9.79 | 449-LFSPXO019966REEL | Link (http://www.mouser.com/ProductDetail/IQD/LFSPXO019966Reel/) |  |  | $1.40 | $14.00 | 94X0882 | Link (http://www.newark.com/webapp/wcs/stores/servlet/Search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) | 2428 |  | $0.90 | $9.04 | 814-1626 | Link (http://it.rs-online.com/web/c/?searchTerm=LFSPXO019966%20)
D1002 | LM4041EIM3-1.2/NOPB |  | TO_SOT_Packages_SMD:SOT-23 |  | LM4041EIM3-1.2/NOPB | 5 | $0.58 | $2.89 | 1694 |  | $0.76 | $3.80 | LM4041EIM3X-1.2/NOPBCT-ND | Link (http://www.digikey.com/product-detail/en/texas-instruments/LM4041EIM3X-1.2-NOPB/LM4041EIM3X-1.2-NOPBCT-ND/2350863) |  |  | $0.70 | $3.49 | 2436138 | Link (http://it.farnell.com/texas-instruments/lm4041eim3-1-2-nopb/rif-tensione-shunt-1-225v-sot/dp/2436138) | 2499 |  | $0.73 | $3.67 | 926-LM4041EIM312NOPB | Link (http://www.mouser.com/ProductDetail/Texas-Instruments/LM4041EIM3-12-NOPB/) |  |  | $0.73 | $3.64 | 41K5322 | Link (http://www.newark.com/texas-instruments/lm4041eim3-1-2-nopb/voltage-ref-shunt-1-225v-sot-23/dp/41K5322) | 25 |  | $0.58 | $2.89 | 811-5636 | Link (http://it.rs-online.com/web/c/?searchTerm=LM4041EIM3-1.2%2FNOPB%20)
R702,R706 | 887K |  | Resistors_SMD:R_0603_HandSoldering |  | RC0603FR-07887KL | 10 | $0.01 | $0.05 | 178012 |  | $0.01 | $0.15 | 311-887KHRCT-ND | Link (http://www.digikey.com/product-detail/en/yageo/RC0603FR-07887KL/311-887KHRCT-ND/730364) |  |  |  |  |  |  | 45100 |  | $0.01 | $0.11 | 603-RC0603FR-07887KL | Link (http://www.mouser.com/Search/Refine.aspx?Keyword=RC0603FR-07887KL%20) |  |  | $0.01 | $0.05 | 66R2611 | Link (http://www.newark.com/webapp/wcs/stores/servlet/Search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)
U803 | CLC4007 |  | Housings_SSOP:TSSOP-14_4.4x5mm_Pitch0.65mm |  | CLC4007 | 5 | $0.98 | $4.91 |  |  |  |  |  |  |  |  |  |  |  |  | 250 |  | $3.42 | $17.10 | 701-CLC4007ITP14MTR | Link (http://www.mouser.com/ProductDetail/Exar/CLC4007ITP14MTR/) |  |  |  |  |  |  |  |  | $0.98 | $4.91 | 791-7472 | Link (http://it.rs-online.com/web/p/amplificatori-operazionali/7917472/)
R1006-R1009,R1113,R1116 | 4K7 |  | Resistors_SMD:R_0603_HandSoldering |  | RC0603FR-074K7L | 30 | $0.0044646 | $0.13 | 4382752 |  | $0.01 | $0.45 | 311-4.70KHRCT-ND | Link (http://www.digikey.com/product-detail/en/yageo/RC0603FR-074K7L/311-4.70KHRCT-ND/730159) |  |  | $0.0044646 | $0.13 | 2363478 | Link (http://it.farnell.com/yageo/rc0603fr-074k7l/res-thick-film-4k7-1-0-1w-0603/dp/2363478) | 1050006 |  | $0.01 | $0.33 | 603-RC0603FR-074K7L | Link (http://www.mouser.com/Search/Refine.aspx?Keyword=RC0603FR-074K7L%20) |  |  | $0.01 | $0.30 | 68R0092 | Link (http://www.newark.com/yageo/rc0603fr-074k7l/res-thick-film-4k7-1-0-1w-0603/dp/68R0092)
U903 | MIC5270 |  | TO_SOT_Packages_SMD:SOT-23-5 |  | MIC5270 | 5 | $1.28 | $6.38 | 12869 |  | $1.62 | $8.10 | 576-1295-1-ND | Link (http://www.digikey.com/product-detail/en/microchip-technology/MIC5270YM5-TR/576-1295-1-ND/771912) |  |  | $1.28 | $6.38 | 2510309 | Link (http://it.farnell.com/microchip/mic5270ym5-tr/ldo-ve-0-5vdo-0-1a-adj-3-5sot23/dp/2510309) | 9231 |  | $1.69 | $8.45 | 998-MIC5270YM5TR | Link (http://www.mouser.com/ProductDetail/Microchip-Technology-Micrel/MIC5270YM5-TR/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) |  |  | $1.61 | $8.05 | 72Y5346 | Link (http://www.newark.com/microchip/mic5270ym5-tr/ldo-adj-1-24v-to-14v-0-1a-sot/dp/72Y5346) | 1585 |  | $2.39 | $11.95 | 910-1698 | Link (http://it.rs-online.com/web/p/regolatori-di-tensione-low-dropout/9101698/)
R212,R309-R322 | 1K |  | Resistors_SMD:R_0603_HandSoldering |  | RC0603FR-071KL | 75 | $0.01 | $0.62 | 8252962 |  | $0.01 | $1.12 | 311-1.00KHRCT-ND | Link (http://www.digikey.com/product-detail/en/yageo/RC0603FR-071KL/311-1.00KHRCT-ND/729790) |  |  | $0.01 | $0.62 | 9238484 | Link (http://it.farnell.com/yageo-phycomp/rc0603fr-071kl/res-film-spesso-1k-1-0-1w-0603/dp/9238484) | 1827498 |  | $0.01 | $0.82 | 603-RC0603FR-071KL | Link (http://www.mouser.com/Search/Refine.aspx?Keyword=RC0603FR-071KL%20) |  |  | $0.01 | $0.75 | 68R0042 | Link (http://www.newark.com/yageo/rc0603fr-071kl/res-thick-film-1k-1-0-1w-0603/dp/68R0042)
C202,C203,C310,C312 | 10nF |  | Capacitors_SMD:C_0603_HandSoldering |  | C0603C103K5RECTU | 20 | $0.02 | $0.49 | 8000 |  | $0.02 | $0.49 | 399-14172-2-ND | Link (http://www.digikey.com/scripts/DkSearch/dksus.dll?WT.z_header=search_go&lang=en) |  |  |  |  |  |  | 9545 |  | $0.06 | $1.20 | 80-C0603C103K5REC | Link (http://www.mouser.com/Search/Refine.aspx?Keyword=C0603C103K5RECTU%20)
D202,D204,D401-D408 | GREEN |  | LEDs:LED_0603 |  | APTD1608LCGCK | 50 | $0.22 | $10.85 | 2000 |  | $0.26 | $12.98 | 754-2037-1-ND | Link (http://www.digikey.com/product-detail/en/kingbright/APTD1608LCGCK/754-2037-1-ND/7043091) |  |  |  |  |  |  | 3808 |  | $0.22 | $10.85 | 604-APTD1608LCGCK | Link (http://www.mouser.com/Search/Refine.aspx?Keyword=APTD1608LCGCK%20)
R701,R705 | 13K |  | Resistors_SMD:R_0603_HandSoldering |  | RC0603FR-0713KL | 10 | $0.0044646 | $0.04 | 355490 |  | $0.01 | $0.15 | 311-13.0KHRCT-ND | Link (http://www.digikey.com/product-detail/en/yageo/RC0603FR-0713KL/311-13.0KHRCT-ND/729876) |  |  | $0.0044646 | $0.04 | 2413675 | Link (http://it.farnell.com/yageo/rc0603fr-0713kl/res-thick-film-13k-1-0-1w-0603/dp/2413675) | 65380 |  | $0.01 | $0.11 | 603-RC0603FR-0713KL | Link (http://www.mouser.com/Search/Refine.aspx?Keyword=RC0603FR-0713KL%20) |  |  | $0.01 | $0.14 | 68R0057 | Link (http://www.newark.com/yageo/rc0603fr-0713kl/res-thick-film-13k-1-0-1w-0603/dp/68R0057)
C705,C708 | 5-20pF |  | Capacitors_THT:CP_Radial_Tantal_D6.0mm_P5.00mm |  | GKG20015 | 10 | $1.77 | $17.70 | 5885 |  | $2.35 | $23.45 | SG9029-ND | Link (http://www.digikey.com/scripts/DkSearch/dksus.dll?WT.z_header=search_go&lang=en&keywords=GKG20015%20) |  |  |  |  |  |  | 11024 |  | $1.77 | $17.70 | 659-GKG20015 | Link (http://www.mouser.com/Search/Refine.aspx?Keyword=GKG20015%20)
R829,R832 | 2K2 |  | Resistors_SMD:R_0603_HandSoldering |  | RC0603FR-072K2L | 10 | $0.0044646 | $0.04 | 2995406 |  | $0.01 | $0.15 | 311-2.20KHRCT-ND | Link (http://www.digikey.com/product-detail/en/yageo/RC0603FR-072K2L/311-2.20KHRCT-ND/729963) |  |  | $0.0044646 | $0.04 | 2413680 | Link (http://it.farnell.com/yageo/rc0603fr-072k2l/res-thick-film-2k2-1-0-1w-0603/dp/2413680) | 733536 |  | $0.01 | $0.11 | 603-RC0603FR-072K2L | Link (http://www.mouser.com/Search/Refine.aspx?Keyword=RC0603FR-072K2L%20) |  |  | $0.01 | $0.14 | 68R0064 | Link (http://www.newark.com/yageo/rc0603fr-072k2l/res-thick-film-2k2-1-0-1w-0603/dp/68R0064)
J105-J108 | MountingHole |  | library:MountingHole |  |  | 20 | $0.00 | $0.00
L201-L204 | L_BLM18BA750SZ1D |  | Inductors_SMD:L_0603_HandSoldering |  | BLM18AG121SN1D | 20 | $0.03 | $0.64 | 595822 |  | $0.08 | $1.58 | 490-1011-1-ND | Link (http://www.digikey.com/product-detail/en/murata-electronics-north-america/BLM18AG121SN1D/490-1011-1-ND/584459) |  |  | $0.03 | $0.64 | 1515672 | Link (http://it.farnell.com/murata/blm18ag121sn1d/ferrite-bead-0-18ohm-500ma-0603/dp/1515672) | 111537 |  | $0.06 | $1.28 | 81-BLM11A121S | Link (http://www.mouser.com/Search/Refine.aspx?Keyword=BLM18AG121SN1D%20) |  |  | $0.06 | $1.28 | 73M9051 | Link (http://www.newark.com/webapp/wcs/stores/servlet/Search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) | 720 |  | $0.08 | $1.53 | 202-3550 | Link (http://it.rs-online.com/web/c/?searchTerm=BLM18AG121SN1D%20)
U302 | FLASH 2Mb |  | Housings_SOIC:SOIC-8_3.9x4.9mm_Pitch1.27mm |  | LE25U20AMB-AH | 5 | $0.48 | $2.41 | 2309 |  | $0.55 | $2.75 | LE25U20AMB-AHOSCT-ND | Link (http://www.digikey.com/product-detail/en/on-semiconductor/LE25U20AMB-AH/LE25U20AMB-AHOSCT-ND/5213250) |  |  | $0.66 | $3.31 | 2774638 | Link (http://it.farnell.com/on-semiconductor/le25u20amb-ah/flash-seriale-2mbit-30mhz-soic/dp/2774638) | 2959 |  | $0.71 | $3.56 | 863-LE25U20AMB-AH | Link (http://www.mouser.com/Search/Refine.aspx?Keyword=LE25U20AMB-AH%20) |  |  | $0.86 | $4.29 | 30AC9756 | Link (http://www.newark.com/webapp/wcs/stores/servlet/Search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) | 2000 |  | $0.48 | $2.41 | 805-1306 | Link (http://it.rs-online.com/web/c/?searchTerm=LE25U20AMB-AH%20)
R709,R710,R801,R803,R1002,R1005,R1103,R1104 | 0R |  | Resistors_SMD:R_0603_HandSoldering |  | RC1206JR-070RL | 40 | $0.01 | $0.58 | 8491390 |  | $0.02 | $0.69 | 311-0.0ERCT-ND | Link (http://www.digikey.com/product-detail/en/yageo/RC1206JR-070RL/311-0.0ERCT-ND/732131) |  |  | $0.01 | $0.58 | 9240276 | Link (http://it.farnell.com/yageo-phycomp/rc1206jr-070rl/res-film-spesso-0r-5-0-25w-1206/dp/9240276) | 1140411 |  | $0.02 | $0.72 | 603-RC1206JR-070RL | Link (http://www.mouser.com/Search/Refine.aspx?Keyword=RC1206JR-070RL%20) |  |  | $0.02 | $0.64 | 68R0297 | Link (http://www.newark.com/yageo/rc1206jr-070rl/res-thick-film-0r-0-25w-1206/dp/68R0297)
R208 | 2K2 |  | Resistors_SMD:R_0603_HandSoldering |  | RC0603FR-072K2L | 5 | $0.0044646 | $0.02 | 2995406 |  | $0.10 | $0.50 | 311-2.20KHRCT-ND | Link (http://www.digikey.com/product-detail/en/yageo/RC0603FR-072K2L/311-2.20KHRCT-ND/729963) |  |  | $0.0044646 | $0.02 | 2413680 | Link (http://it.farnell.com/yageo/rc0603fr-072k2l/res-thick-film-2k2-1-0-1w-0603/dp/2413680) | 733536 |  | $0.10 | $0.50 | 603-RC0603FR-072K2L | Link (http://www.mouser.com/Search/Refine.aspx?Keyword=RC0603FR-072K2L%20) |  |  | $0.08 | $0.40 | 68R0064 | Link (http://www.newark.com/yageo/rc0603fr-072k2l/res-thick-film-2k2-1-0-1w-0603/dp/68R0064)
R821,R823,R824,R826 | 100R |  | Resistors_SMD:R_0603_HandSoldering |  | RC0603FR-07100RL | 20 | $0.01 | $0.17 | 4968232 |  | $0.01 | $0.30 | 311-100HRCT-ND | Link (http://www.digikey.com/product-detail/en/yageo/RC0603FR-07100RL/311-100HRCT-ND/729835) |  |  | $0.01 | $0.17 | 9238360 | Link (http://it.farnell.com/yageo-phycomp/rc0603fr-07100rl/res-film-spesso-100r-1-0-1w-0603/dp/9238360) | 652674 |  | $0.01 | $0.22 | 603-RC0603FR-07100RL | Link (http://www.mouser.com/Search/Refine.aspx?Keyword=RC0603FR-07100RL%20) |  |  | $0.01 | $0.28 | 68R0052 | Link (http://www.newark.com/yageo/rc0603fr-07100rl/res-thick-film-100r-1-0-1w-0603/dp/68R0052)
U1001,U1002 | ADC1175 |  | library:TSSOP-24_4.4x7.8mm_Pitch0.65mm |  | ADC1175CIMTCX/NOPB | 10 | $1.41 | $14.10 | 3122 |  | $2.70 | $26.97 | 296-35235-1-ND | Link (http://www.digikey.com/product-detail/en/texas-instruments/ADC1175CIMTCX-NOPB/296-35235-1-ND/3738943) |  |  | $2.68 | $26.79 | 2496151 | Link (http://it.farnell.com/webapp/wcs/stores/servlet/Search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) | 1330 |  | $2.63 | $26.30 | 926-ADC1175CIMTCXNPB | Link (http://www.mouser.com/ProductDetail/Texas-Instruments/ADC1175CIMTCX-NOPB/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) |  |  | $1.41 | $14.10 | 55K5084 | Link (http://www.newark.com/webapp/wcs/stores/servlet/Search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)
C907 | 10uF |  | Capacitors_SMD:C_1206_HandSoldering |  | TAJA106K016TNJ | 5 | $0.12 | $0.60 |  |  | $0.46 | $2.30 | 478-10744-1-ND | Link (http://www.digikey.com/product-detail/en/avx-corporation/TAJA106K016TNJ/478-10744-1-ND/7536607) |  |  |  |  |  |  | 1756 |  | $0.12 | $0.60 | 581-TAJA106K016TNJ | Link (http://www.mouser.com/Search/Refine.aspx?Keyword=TAJA106K016TNJ%20) |  |  | $0.42 | $2.10 | 60R5827 | Link (http://www.newark.com/avx/taja106k016rnj/tantalum-capacitor-10uf-16v-3/dp/60R5827?rpsku=rel3%3ATAJA106K016TNJ)
R211 | 12K |  | Resistors_SMD:R_0603_HandSoldering |  | RC0603FR-0712KL | 5 | $0.01 | $0.03 | 1166231 |  | $0.10 | $0.50 | 311-12.0KHRCT-ND | Link (http://www.digikey.com/product-detail/en/yageo/RC0603FR-0712KL/311-12.0KHRCT-ND/729860) |  |  | $0.01 | $0.03 | 9238611 | Link (http://it.farnell.com/yageo-phycomp/rc0603fr-0712kl/res-film-spesso-12k-1-0-1w-0603/dp/9238611) | 133763 |  | $0.10 | $0.50 | 603-RC0603FR-0712KL | Link (http://www.mouser.com/ProductDetail/Yageo/RC0603FR-0712KL/) |  |  | $0.08 | $0.40 | 68R0054 | Link (http://www.newark.com/yageo/rc0603fr-0712kl/res-thick-film-12k-1-0-1w-0603/dp/68R0054)
C709,C711 | 180pF |  | Capacitors_SMD:C_0603_HandSoldering |  | VJ0603A181FXXPW1BC | 10 | $0.14 | $1.40 |  |  |  |  |  |  |  |  |  |  |  |  | 6370 |  | $0.14 | $1.40 | 77-VJ0603A181FXXPBC | Link (http://www.mouser.com/Search/Refine.aspx?Keyword=VJ0603A181FXXPW1BC%20)
R101,R201,R207,R209,R210,R301-R306,R704,R708,R1105-R1110 | 10K |  | Resistors_SMD:R_0603_HandSoldering |  | RT0603DRE0710KL | 95 | $0.03 | $2.47 | 51306 |  | $0.11 | $10.64 | YAG2318CT-ND | Link (http://www.digikey.com/product-detail/en/yageo/RT0603DRE0710KL/YAG2318CT-ND/5252432) |  |  |  |  |  |  | 21669 |  | $0.07 | $6.75 | 603-RT0603DRE0710KL | Link (http://www.mouser.com/Search/Refine.aspx?Keyword=RT0603DRE0710KL%20) |  |  | $0.03 | $2.47 | 66R7868 | Link (http://www.newark.com/webapp/wcs/stores/servlet/Search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)
R1001,R1004 | 50R |  | Resistors_SMD:R_0805_HandSoldering |  | CRCW080550R0FKTA | 10 | $0.08 | $0.77 |  |  |  |  |  |  |  |  |  |  |  |  | 30280 |  | $0.08 | $0.77 | 71-CRCW0805-50 | Link (http://www.mouser.com/Search/Refine.aspx?Keyword=CRCW080550R0FKTA%20)
D701,D702,D1006,D1007 | D_Schottky_BAT54S-7-F |  | TO_SOT_Packages_SMD:SOT-23 |  | BAT54S | 20 | $0.14 | $2.72 |  |  |  |  |  |  |  |  | $0.19 | $3.81 | 2323106 | Link (http://it.farnell.com/fairchild-semiconductor/bat54s/diodo-schottky-100ma-30v-sot-23/dp/2323106) | 24623 |  | $0.14 | $2.72 | 512-BAT54S | Link (http://www.mouser.com/ProductDetail/ON-Semiconductor-Fairchild/BAT54S/) |  |  | $0.25 | $5.00 | 35C0399 | Link (http://www.newark.com/fairchild-semiconductor/bat54s/dual-schottky-rectifier-series/dp/35C0399) |  |  | $0.14 | $2.76 | 544-4584 | Link (http://it.rs-online.com/web/p/diodi-rettificatori-e-schottky/5444584/)
C710,C712 | 1800pF |  | Capacitors_SMD:C_0603_HandSoldering |  | GRM1885C1H182FA01D | 10 | $0.12 | $1.24 | 9042 |  | $0.20 | $1.96 | 490-12714-1-ND | Link (http://www.digikey.com/product-detail/en/murata-electronics-north-america/GRM1885C1H182FA01D/490-12714-1-ND/5797683) |  |  |  |  |  |  | 10565 |  | $0.12 | $1.24 | 81-GRM1885C1H182FA1D | Link (http://www.mouser.com/Search/Refine.aspx?Keyword=GRM1885C1H182FA01D%20)
R811,R812,R815,R817,R818,R820,R1003,R1012,R1013 | 220R |  | Resistors_SMD:R_0603_HandSoldering |  | RC0603JR-07220RL | 45 | $0.01 | $0.25 | 1293516 |  | $0.01 | $0.49 | 311-220GRCT-ND | Link (http://www.digikey.com/product-detail/en/yageo/RC0603JR-07220RL/311-220GRCT-ND/729688) |  |  | $0.01 | $0.25 | 9233296 | Link (http://it.farnell.com/yageo-phycomp/rc0603jr-07220rl/res-film-spesso-220r-5-0-1w-0603/dp/9233296) | 243904 |  | $0.01 | $0.36 | 603-RC0603JR-07220RL | Link (http://www.mouser.com/ProductDetail/Yageo/RC0603JR-07220RL/) |  |  | $0.01 | $0.32 | 68R0170 | Link (http://www.newark.com/yageo/rc0603jr-07220rl/res-thick-film-220r-5-0-1w-0603/dp/68R0170)
J1101 | CONN_01X25 |  | Pin_Headers:Pin_Header_Straight_1x25_Pitch1.27mm |  | M52-5002545 | 5 | $2.14 | $10.70 | 359 |  | $2.67 | $13.35 | 952-1907-ND | Link (http://www.digikey.com/scripts/DkSearch/dksus.dll?WT.z_header=search_go&lang=en) |  |  | $2.18 | $10.90 | 1099546 | Link (http://it.farnell.com/webapp/wcs/stores/servlet/Search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) | 21 |  | $2.68 | $13.40 | 855-M52-5002545 | Link (http://www.mouser.com/Search/Refine.aspx?Keyword=M52-5002545%20) |  |  | $2.14 | $10.70 | 97K6324 | Link (http://www.newark.com/webapp/wcs/stores/servlet/Search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) |  |  | $3.13 | $15.67 | 681-3039 | Link (http://it.rs-online.com/web/p/prese-da-pcb/6813039/)
R1114,R1117 | 1K2 |  | Resistors_SMD:R_0603_HandSoldering |  | RC0603FR-071K2L | 10 | $0.01 | $0.07 | 538594 |  | $0.01 | $0.15 | 311-1.20KHRCT-ND | Link (http://www.digikey.com/product-detail/en/yageo/RC0603FR-071K2L/311-1.20KHRCT-ND/729799) |  |  | $0.01 | $0.07 | 9238492 | Link (http://it.farnell.com/yageo-phycomp/rc0603fr-071k2l/res-film-spesso-1k2-1-0-1w-0603/dp/9238492) | 146172 |  | $0.01 | $0.11 | 603-RC0603FR-071K2L | Link (http://www.mouser.com/ProductDetail/Yageo/RC0603FR-071K2L/?qs=sGAEpiMZZMu61qfTUdNhG5eFuApKbqVdGHoRw3xWRI8%3D) |  |  | $0.01 | $0.14 | 68R0044 | Link (http://www.newark.com/yageo/rc0603fr-071k2l/res-thick-film-1k2-1-0-1w-0603/dp/68R0044)
U703,U704,U801,U802 | CD4051BM96 |  | Housings_SOIC:SOIC-16_3.9x9.9mm_Pitch1.27mm |  | CD4051BM96 | 20 | $0.13 | $2.57 | 4562 |  | $0.37 | $7.42 | 296-14271-1-ND | Link (http://www.digikey.com/product-detail/en/texas-instruments/CD4051BM96/296-14271-1-ND/528348) |  |  | $0.13 | $2.57 | 2334931 | Link (http://it.farnell.com/texas-instruments/cd4051bm96/mux-single-8ch-soic-16/dp/2334931) | 2657 |  | $0.35 | $6.96 | 595-CD4051BM96 | Link (http://www.mouser.com/ProductDetail/Texas-Instruments/CD4051BM96/) |  |  | $0.35 | $6.94 | 05B5596 | Link (http://www.newark.com/texas-instruments/cd4051bm96/analog-mux-dmux-8-x-1-soic-16/dp/05B5596) |  |  | $0.32 | $6.40 | 528-393 | Link (http://it.rs-online.com/web/c/?searchTerm=CD4051BM96%20)
U501 | AS4C1M16S |  | TSOP50-II:TSOP50-II |  | AS4C1M16S | 5 | $1.22 | $6.11 | 4324 |  | $1.87 | $9.35 | 1450-1004-ND | Link (http://www.digikey.com/product-detail/en/alliance-memory-inc/AS4C1M16S-7TCN/1450-1004-ND/4234563) |  |  |  |  |  |  | 416 |  | $1.65 | $8.25 | 913-AS4C1M16S-7TCN | Link (http://www.mouser.com/ProductDetail/Alliance-Memory/AS4C1M16S-7TCN/) |  |  |  |  |  |  |  |  | $1.22 | $6.11 | 797-5790 | Link (http://it.rs-online.com/web/c/?searchTerm=AS4C1M16S%20)
U701,U702 | CPC1017N |  | library:2.54SOP4 |  | CPC1017N | 10 | $0.60 | $5.99 |  |  | $0.60 | $5.99 | CLA153-ND | Link (http://www.digikey.com/product-detail/en/ixys-integrated-circuits-division/CPC1017N/CLA153-ND/555063) |  |  |  |  |  |  | 26883 |  | $0.85 | $8.53 | 849-CPC1017N | Link (http://www.mouser.com/ProductDetail/IXYS-Integrated-Circuits/CPC1017N/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) |  |  | $0.61 | $6.12 | 70C4236 | Link (http://www.newark.com/clare/cpc1017n/ic-normally-open-pc-mount-solid/dp/70C4236) |  |  | $1.27 | $12.67 | 906-1017 | Link (http://it.rs-online.com/web/c/?searchTerm=CPC1017N%20)
R307,R308 | 100R |  | Resistors_SMD:R_0603_HandSoldering |  | RC0603FR-07100RL | 10 | $0.01 | $0.08 | 4968232 |  | $0.01 | $0.15 | 311-100HRCT-ND | Link (http://www.digikey.com/product-detail/en/yageo/RC0603FR-07100RL/311-100HRCT-ND/729835) |  |  | $0.01 | $0.08 | 9238360 | Link (http://it.farnell.com/yageo-phycomp/rc0603fr-07100rl/res-film-spesso-100r-1-0-1w-0603/dp/9238360) | 652674 |  | $0.01 | $0.11 | 603-RC0603FR-07100RL | Link (http://www.mouser.com/Search/Refine.aspx?Keyword=RC0603FR-07100RL%20) |  |  | $0.01 | $0.14 | 68R0052 | Link (http://www.newark.com/yageo/rc0603fr-07100rl/res-thick-film-100r-1-0-1w-0603/dp/68R0052)
R703,R707 | 90K9 |  | Resistors_SMD:R_0603_HandSoldering |  | RR0816P-9092-D-93C | 10 | $0.01 | $0.11 | 17755 |  | $0.10 | $0.98 | RR08P90.9KDCT-ND | Link (http://www.digikey.com/product-detail/en/susumu/RR0816P-9092-D-93C/RR08P90.9KDCT-ND/433086) |  |  |  |  |  |  | 2006 |  | $0.05 | $0.51 | 754-RR0816P-9092D93C | Link (http://www.mouser.com/Search/Refine.aspx?Keyword=RR0816P-9092-D-93C%20) |  |  | $0.01 | $0.11 | 28K4847 | Link (http://www.newark.com/webapp/wcs/stores/servlet/Search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)
C602,C604,C607,C609,C611,C613,C615,C617,C622,C624,C626,C628,C630,C632,C634,C636,C903,C904,C906 | 1uF |  | Capacitors_SMD:C_0603_HandSoldering |  | C0603C105K8PACTU | 95 | $0.02 | $1.80 | 533526 |  | $0.05 | $4.66 | 399-3118-1-ND | Link (http://www.digikey.com/product-detail/en/kemet/C0603C105K8PACTU/399-3118-1-ND/551623) |  |  | $0.02 | $2.07 | 9227776 | Link (http://it.farnell.com/kemet/c0603c105k8pactu/condensatore-mlcc-x5r-1uf-10v/dp/9227776) | 121568 |  | $0.02 | $2.09 | 80-C0603C105K8P | Link (http://www.mouser.com/ProductDetail/KEMET/C0603C105K8PACTU/?qs=sGAEpiMZZMs0AnBnWHyRQFqPnX0OlvcoH0hWHQB3lFc%3D) |  |  | $0.02 | $1.80 | 70K9090 | Link (http://www.newark.com/kemet/c0603c105k8pactu/ceramic-capacitor-1uf-10v-x5r/dp/70K9090) | 3350 |  | $0.02 | $2.02 | 461-2708 | Link (http://it.rs-online.com/web/c/?searchTerm=C0603C105K8PACTU%20)
U301 | iCE40-HX4K-TQ144 |  | Housings_QFP:LQFP-144_20x20mm_Pitch0.5mm |  | iCE40-HX4K-TQ144 | 5 | $6.82 | $34.10 | 436 |  | $6.97 | $34.85 | 220-1572-ND | Link (http://www.digikey.com/scripts/DkSearch/dksus.dll?WT.z_header=search_go&lang=en) |  |  |  |  |  |  | 706 |  | $6.82 | $34.10 | 842-ICE40HX4K-TQ144 | Link (http://www.mouser.com/Search/Refine.aspx?Keyword=iCE40-HX4K-TQ144%20) |  |  |  |  |  |  | 60 |  | $7.02 | $35.08 | 772-0057 | Link (http://it.rs-online.com/web/p/fpga/7720057/)
U204 | MIC5355-S4YMME |  | Housings_SSOP:MSOP-8_3x3mm_Pitch0.65mm |  | MIC5355-S4YMME | 5 | $0.53 | $2.65 | 685 |  | $0.53 | $2.65 | 576-3880-5-ND | Link (http://www.digikey.com/product-detail/en/microchip-technology/MIC5355-S4YMME/576-3880-5-ND/2650442) |  |  |  |  |  |  | 868 |  | $0.54 | $2.71 | 998-MIC5355-S4YMME | Link (http://www.mouser.com/ProductDetail/Microchip-Technology-Micrel/MIC5355-S4YMME/)
C703,C706 | 22pF |  | Capacitors_SMD:C_0603_HandSoldering |  | 06031U220FAT2A | 10 | $0.07 | $0.73 | 15750 |  | $0.25 | $2.53 | 478-10233-1-ND | Link (http://www.digikey.com/product-detail/en/avx-corporation/06031U220FAT2A/478-10233-1-ND/6797453) |  |  | $0.09 | $0.89 | 2690800 | Link (http://it.farnell.com/webapp/wcs/stores/servlet/Search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) | 8271 |  | $0.10 | $1.00 | 581-06031U220FAT2A | Link (http://www.mouser.com/Search/Refine.aspx?Keyword=06031U220FAT2A%20) |  |  | $0.07 | $0.73 | 55J3520 | Link (http://www.newark.com/webapp/wcs/stores/servlet/Search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)
J202 | USB_OTG |  | library:USB_Micro-B_47642-0001 |  | 47642-0001 | 5 | $0.56 | $2.80 | 13836 |  | $0.81 | $4.05 | WM1398CT-ND | Link (http://www.digikey.com/product-detail/en/molex-llc/0476420001/WM1398CT-ND/2350884) |  |  | $0.56 | $2.80 | 2396171 | Link (http://it.farnell.com/webapp/wcs/stores/servlet/Search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) | 8115 |  | $0.68 | $3.41 | 538-47642-0001 | Link (http://www.mouser.com/Search/Refine.aspx?Keyword=47642-0001%20) |  |  | $0.68 | $3.40 | 78R2131 | Link (http://www.newark.com/webapp/wcs/stores/servlet/Search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) |  |  | $0.61 | $3.05 | 896-7419 | Link (http://it.rs-online.com/web/c/?searchTerm=47642-0001%20)
