smartbench/mainboard/(threads)

Thread 4 (2018-03-05):

PGA resistances

akukulanski, 2018-03-05:
All the resistances inverted... re-do!
Correct for v2

Thread 5 (2018-03-05):

USB footprint

akukulanski, 2018-03-05:
Wrong usb footprint.
Also wrong connection of D+ and D-

Thread 6 (2018-03-05):

Wrong footprint protection diodes

akukulanski, 2018-03-05:
Footprint of D1004 and D1005 are wrong.
Correct for v2.

Thread 9 (2018-03-06):

Not usable FPGA pin

akukulanski, 2018-03-06:
Pin 129 (IOT_198_GBIN0) of the FPGA reserved.
It was connected to the bit [1] of the channel B ADC.
It would be OK to also change the bit[0], currently in Pin 128 (IOT_197_GBIN1)
