smartbench/mainboard/nueva_etapa_analogica/analog_board-B.Cu.pdf

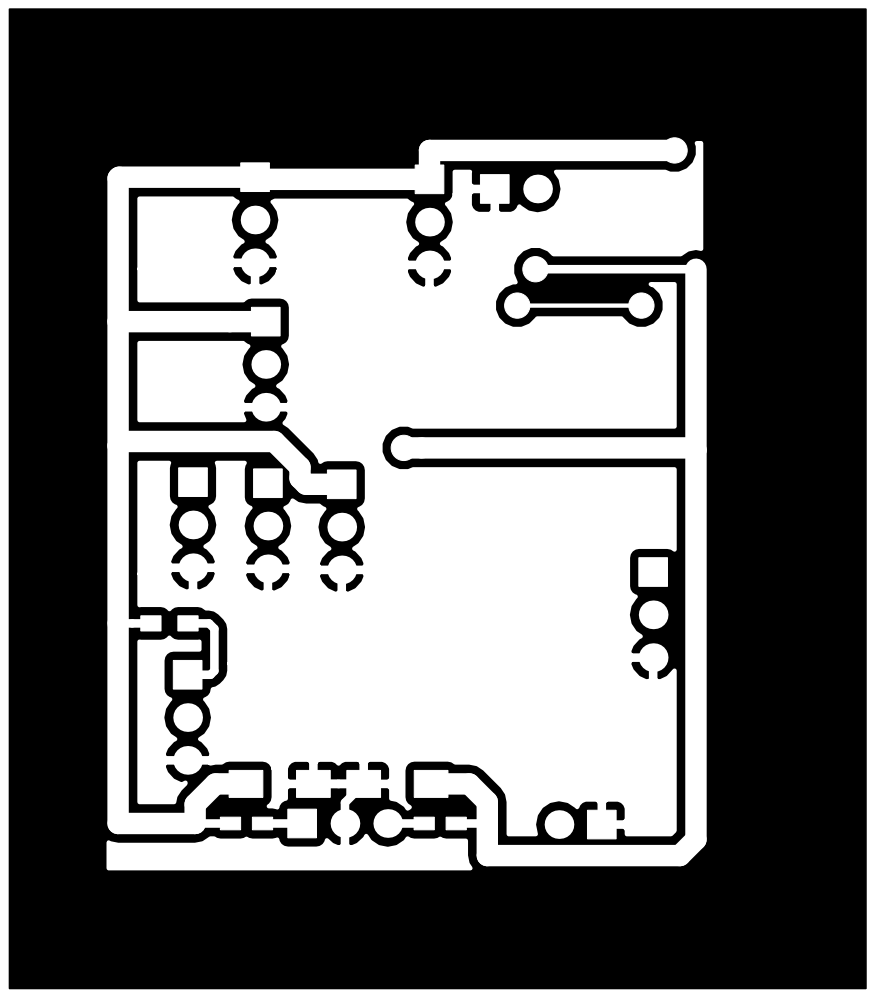
[picture p1: page 1]
