smartbench/mainboard/nueva_etapa_analogica/analog_board-F.Cu.pdf

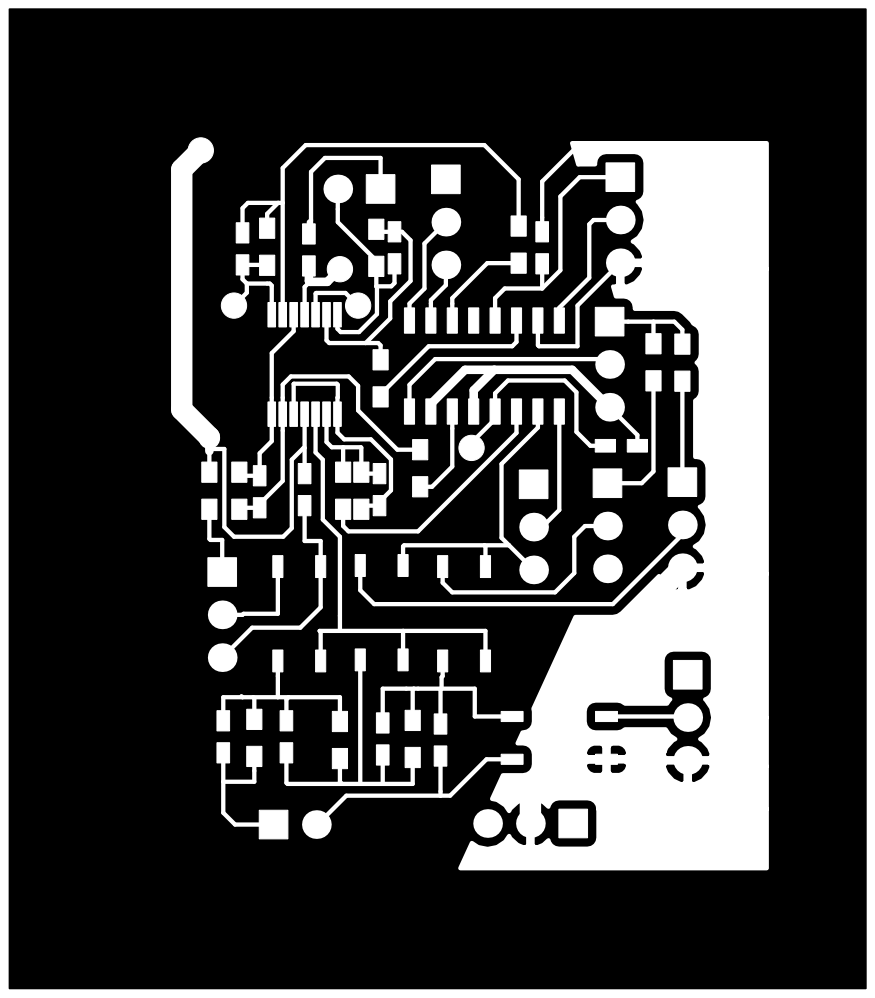
[picture p2: page 1]
