smartbench/mainboard/nueva_etapa_analogica/analog_board-panelized.pdf

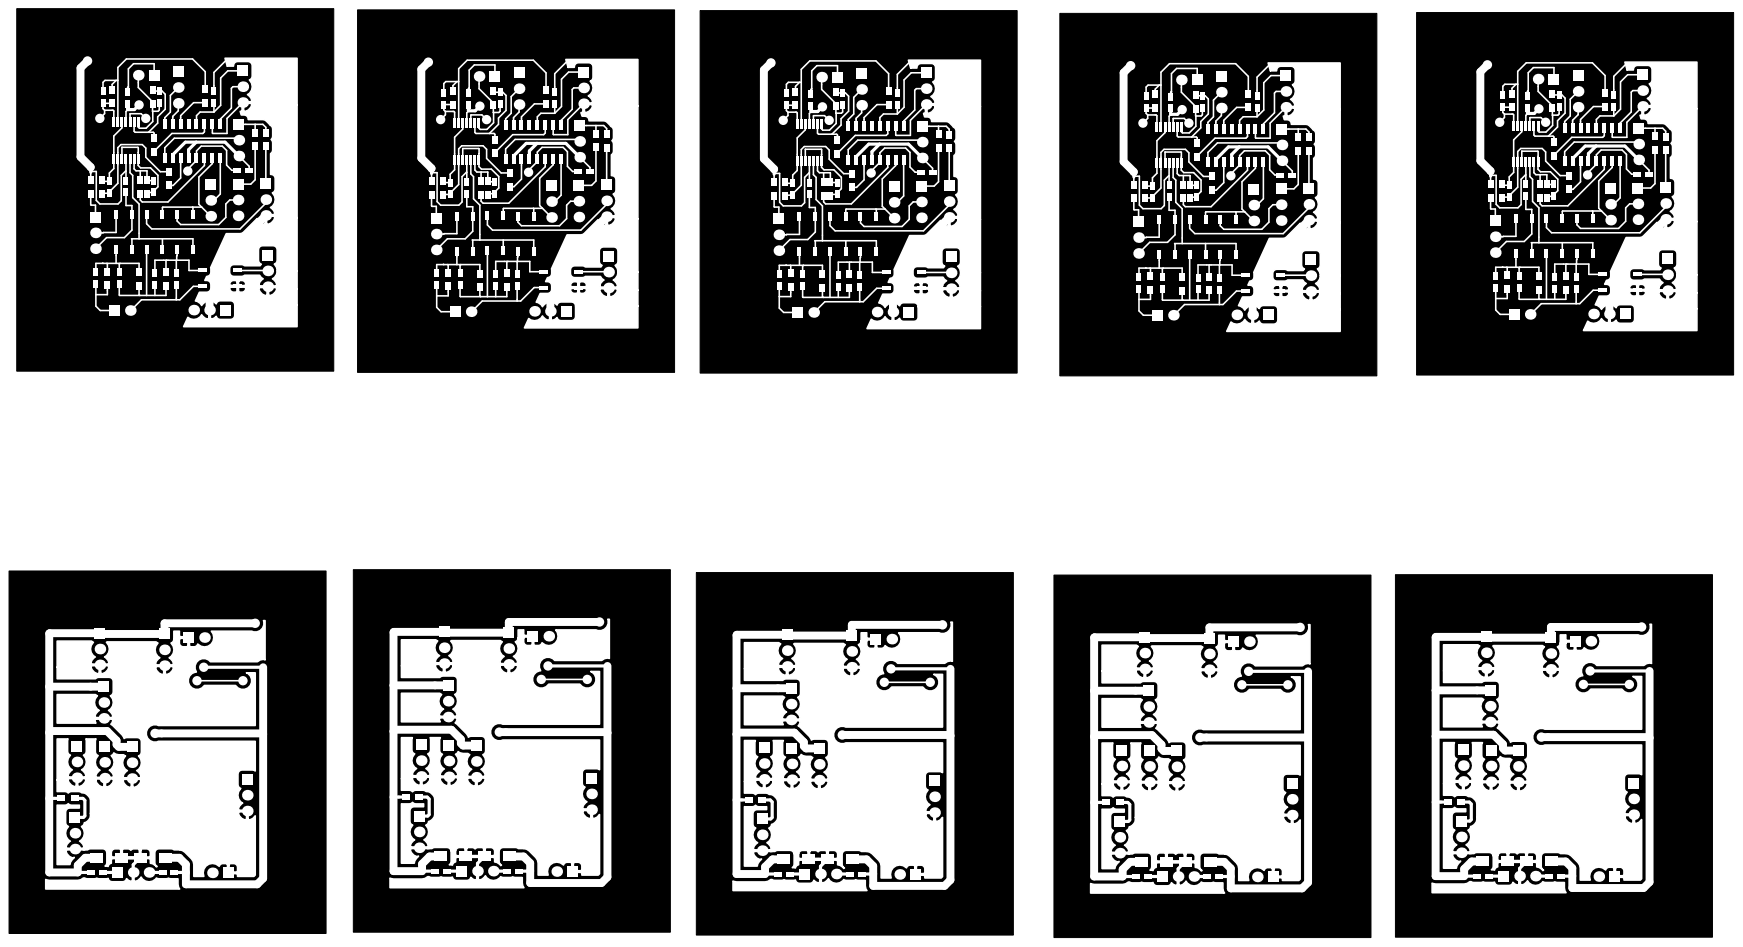
[picture p3: page 1]
