smartbench/mainboard/nueva_etapa_analogica/negative_output/analog_board-B.Cu.pdf

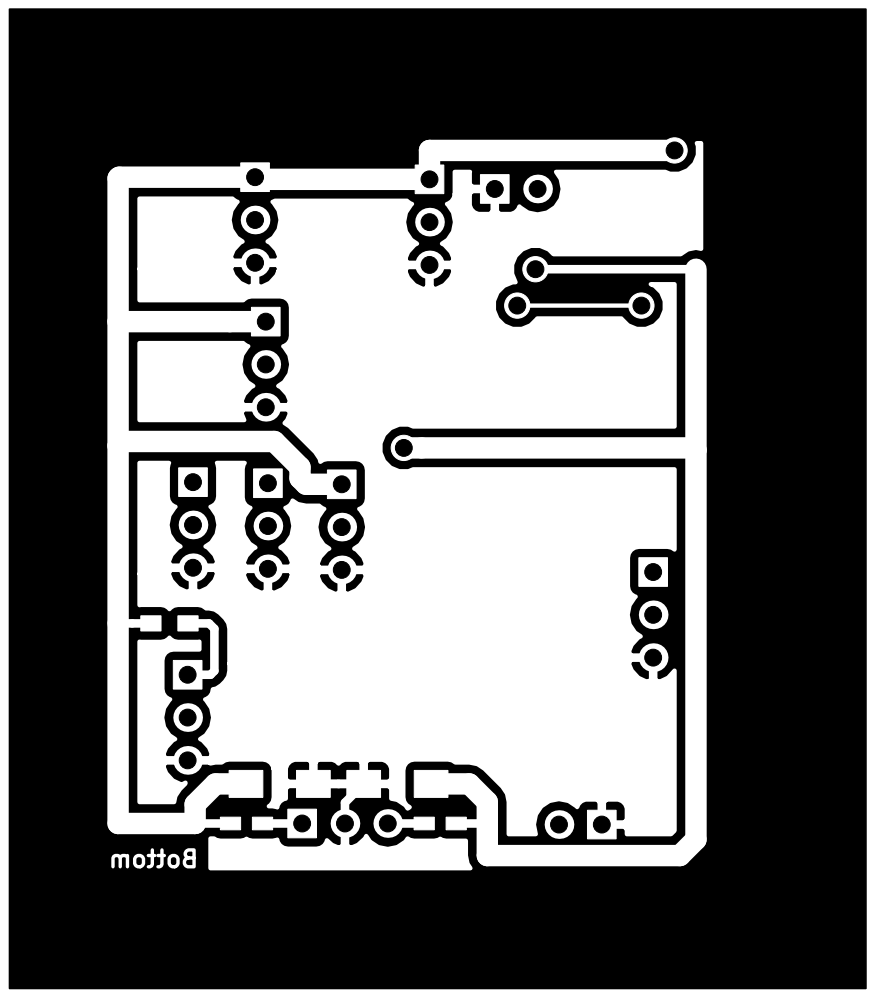
[picture p4: page 1]
