smartbench/mainboard/nueva_etapa_analogica/negative_output/analog_board-F.Cu.pdf

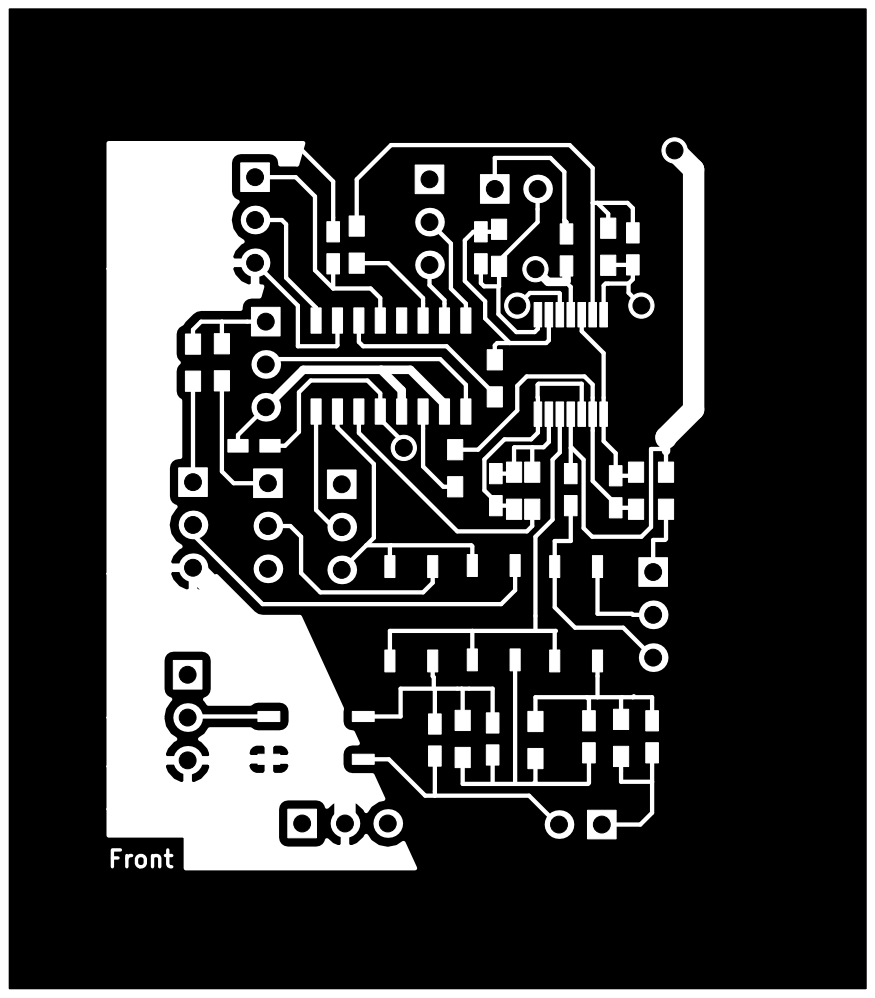
[picture p5: page 1]
