smartbench/mainboard/nueva_etapa_analogica/negative_output/analog_board_panelized.pdf

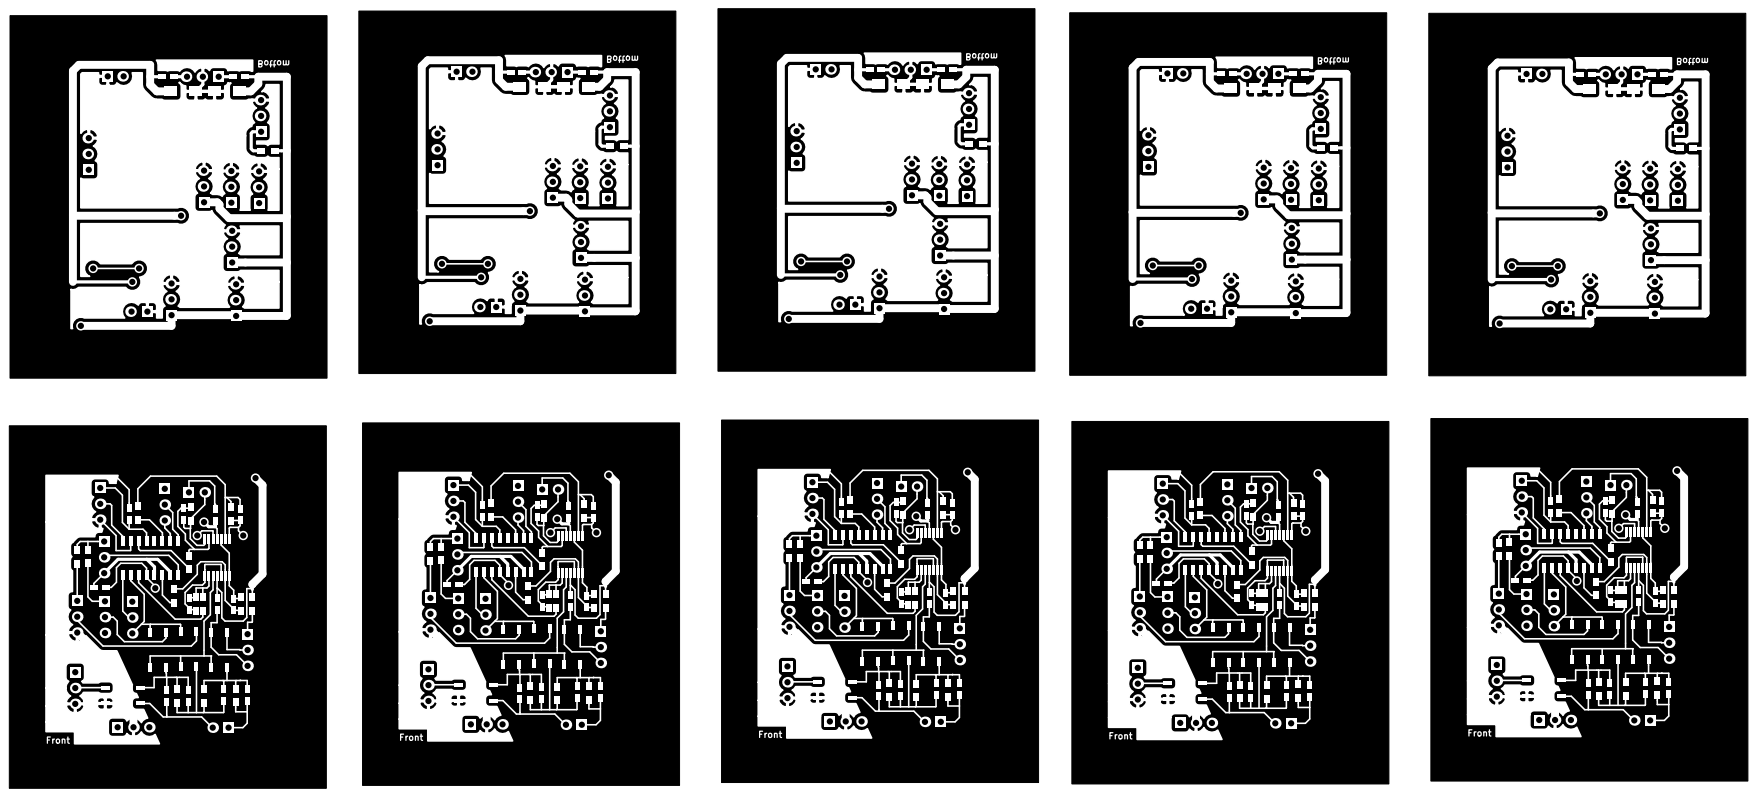
[picture p6: page 1]
