smartbench/mainboard/nueva_etapa_analogica/output/analog_board-B.Cu.pdf

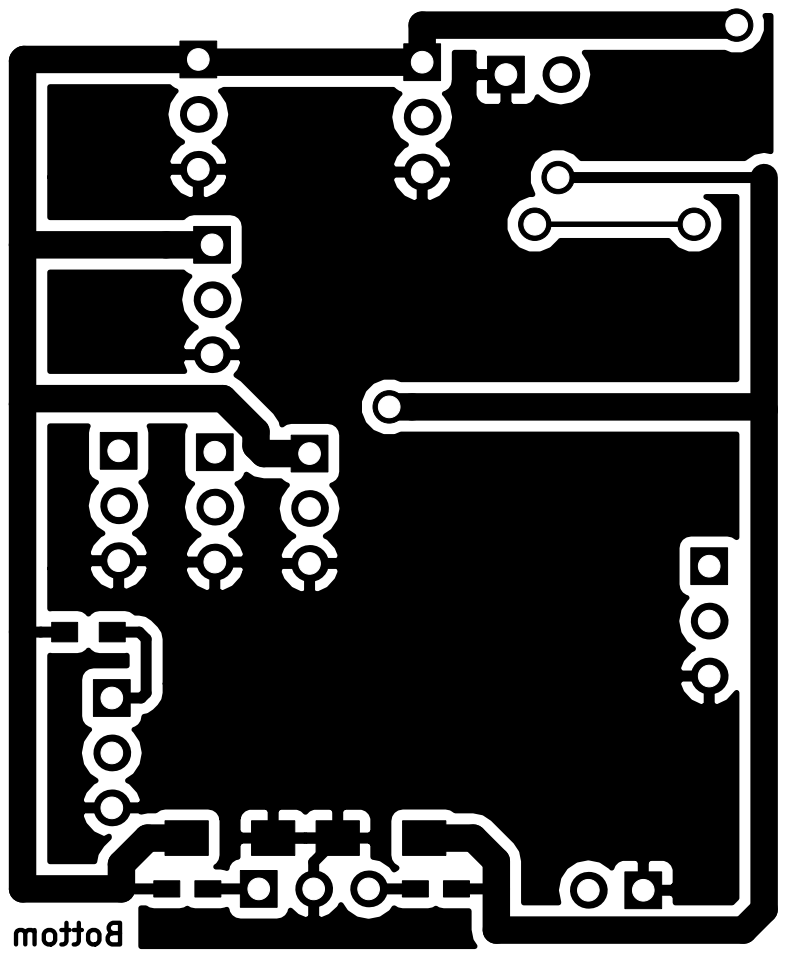
[picture p7: page 1]
