smartbench/mainboard/nueva_etapa_analogica/output/analog_board-F.Cu.pdf

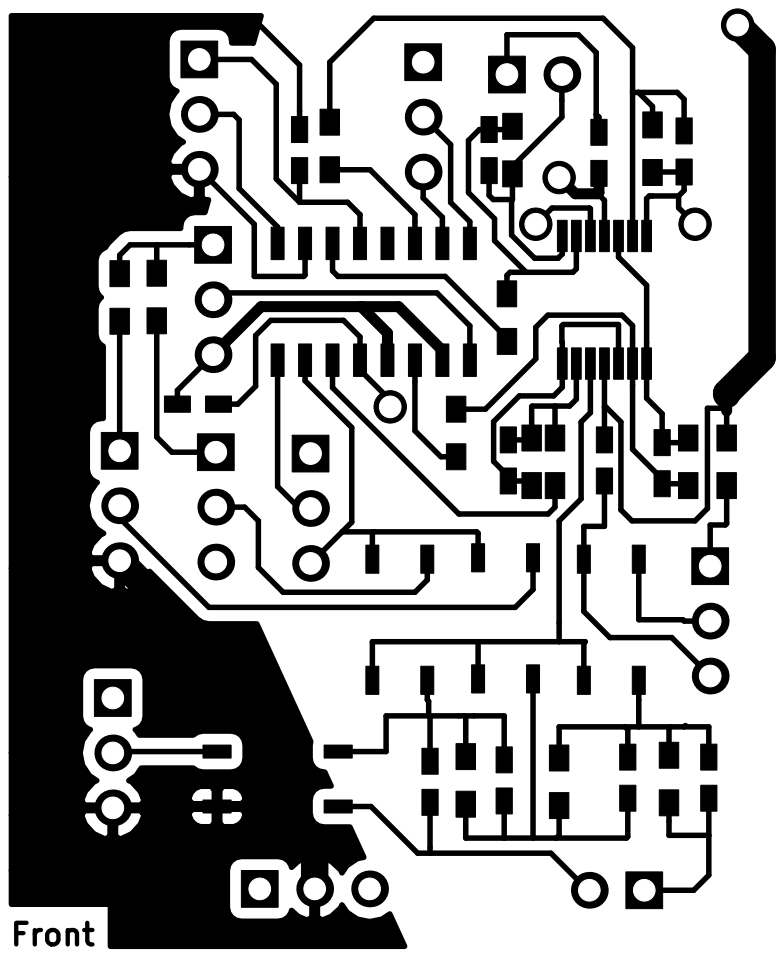
[picture p8: page 1]
