smartbench/mainboard/nueva_etapa_analogica/analog_board.kicad_pcb

## KiCad design nueva_etapa_analogica/analog_board.kicad_pcb (2017-11-25)

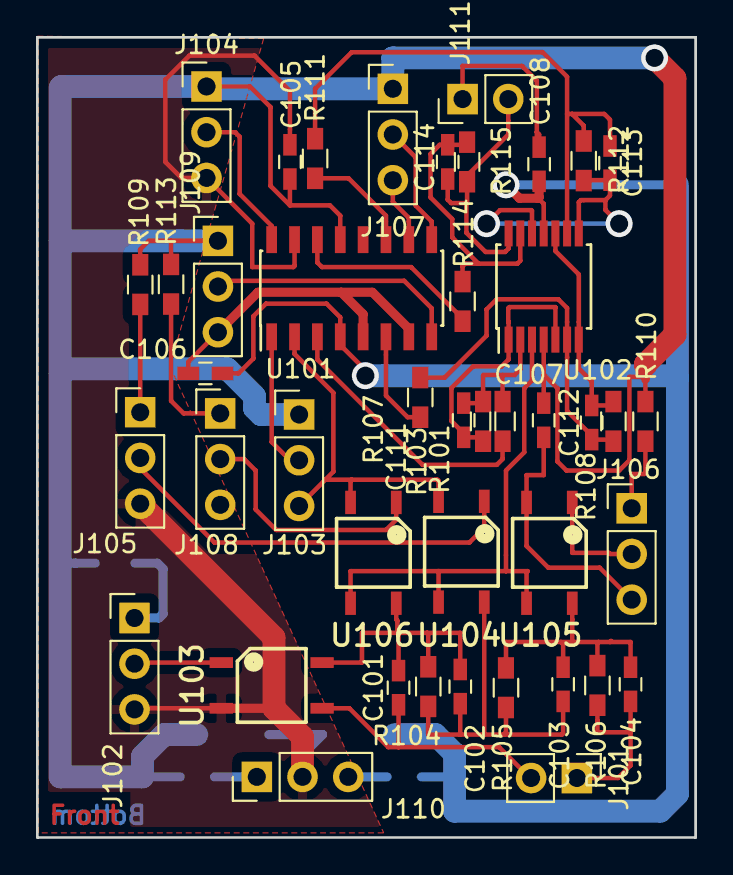
[picture p9: board analog_board.kicad_pcb from above]

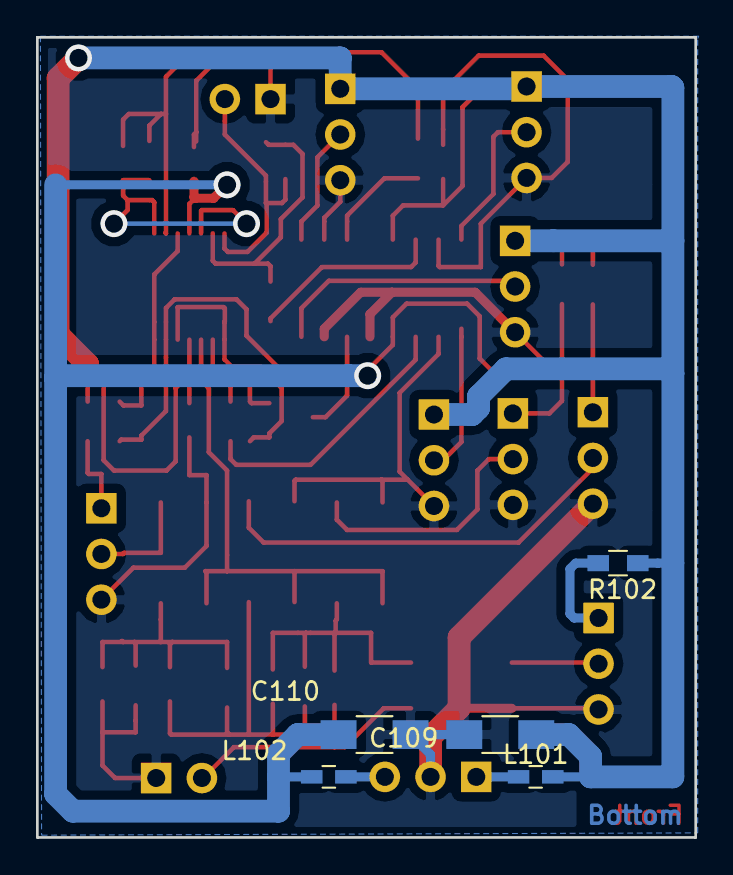
[picture p10: board analog_board.kicad_pcb from below]

Board: 2 copper layers, 36.6 x 44.5 mm, 48 parts (5 on the bottom side), 34 nets.

Parts:
C101, C105, C106, C107, C108: 100nF; C_0603_HandSoldering
C102: 22pF; C_0603_HandSoldering
C103: 180pF; C_0603_HandSoldering
C104: 1800pF; C_0603_HandSoldering
C109, C110: 10uF 10V Tantalum; C_1206_HandSoldering
C111, C112, C113, C114: 10pF; C_0603_HandSoldering
J101, J111: Conn_01x02; Pin_Header_Straight_1x02_Pitch2.54mm
J102, J103, J104, J105, J106, J107, J108, J109, J110: Conn_01x03; Pin_Header_Straight_1x03_Pitch2.54mm
L101, L102: BLM18AG121SN1D; C_0603_HandSoldering
R101, R107, R111, R114: 2K2; R_0603_HandSoldering
R102, R109, R110, R113: 1K; R_0603_HandSoldering
R103, R108, R112: 4K7; R_0603_HandSoldering
R104: 887K; R_0603_HandSoldering
R105: 90K9; R_0603_HandSoldering
R106, R115: 10K; R_0603_HandSoldering
U101: MAX4522CSE+; SOIC-16_3.9x9.9mm_Pitch1.27mm
U102: TLV3544; TSSOP-14_4.4x5mm_Pitch0.65mm
U103, U104, U105, U106: CPC1017N; 2.54SOP4

Connections:
/Vatt: U102.3, U104.3, U105.3, U106.3
/Vin_coupled: C101.1, C102.1, R104.2, U103.4, U106.4
GND: C104.2, C105.2, C106.1, C107.2, C108.1, C109.2, C110.1, J101.1, J102.3, J103.3, J104.3, J105.3, J106.3, J107.3, J108.3, J109.3, J110.2, J111.1, R106.1, U101.2, U101.5, U101.7, U101.10, U101.15, U103.2, U104.2, U105.2, U106.2
unnamed: C101.2, J101.2, U103.3
unnamed: C102.2, C103.1, R104.1, R105.2, U104.4
unnamed: C103.2, C104.1, R105.1, R106.2, U105.4
unnamed: C111.1, R101.2, R103.2, U102.2
unnamed: C111.2, R103.1, U102.1, U102.5
unnamed: C112.1, R107.2, R108.2, U102.6
unnamed: C112.2, R108.1, U102.7, U102.10
unnamed: C113.1, R111.2, R112.2, U102.9
unnamed: C113.2, R112.1, U102.8, U102.12
unnamed: C114.1, R114.2, R115.2, U102.13
unnamed: C114.2, J111.2, R115.1, U102.14
unnamed: J102.1, R102.1
unnamed: J102.2, U103.1
unnamed: J103.2, U101.1
unnamed: J104.2, U101.16
unnamed: J105.1, R109.1
unnamed: J105.2, U104.1
unnamed: J106.1, R110.1
unnamed: J106.2, U105.1
unnamed: J107.2, U101.9
unnamed: J108.1, R113.1
unnamed: J108.2, U106.1
unnamed: J109.2, U101.8
unnamed: J110.1, L101.1
unnamed: J110.3, L102.1
unnamed: R101.1, U101.3
unnamed: R107.1, U101.6
unnamed: R111.1, U101.11
unnamed: R114.1, U101.14
VDD: C105.1, C107.1, C109.1, J103.1, J104.1, J107.1, J109.1, L101.2, R102.2, R109.2, R110.2, R113.2, U101.13, U102.4
VSS: C106.2, C108.2, C110.2, L102.2, U101.4, U102.11
