smartbench/mainboard/iCE40hxk4_dev_board.kicad_pcb

## KiCad design iCE40hxk4_dev_board.kicad_pcb (2017-11-14)

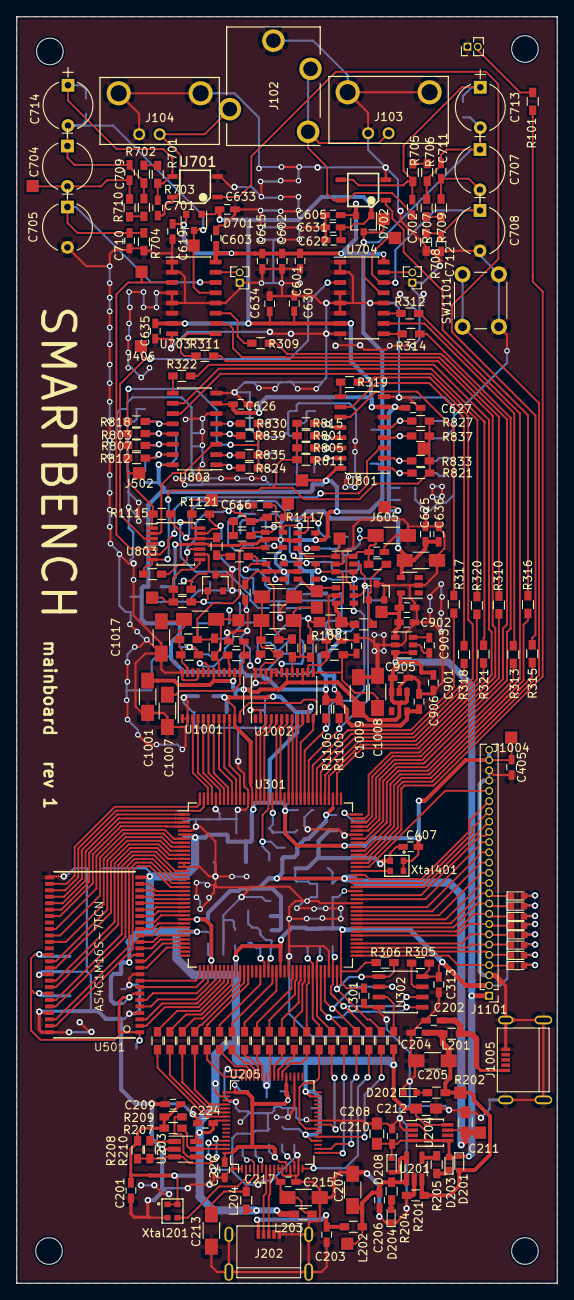
[picture p11: board iCE40hxk4_dev_board.kicad_pcb from above]

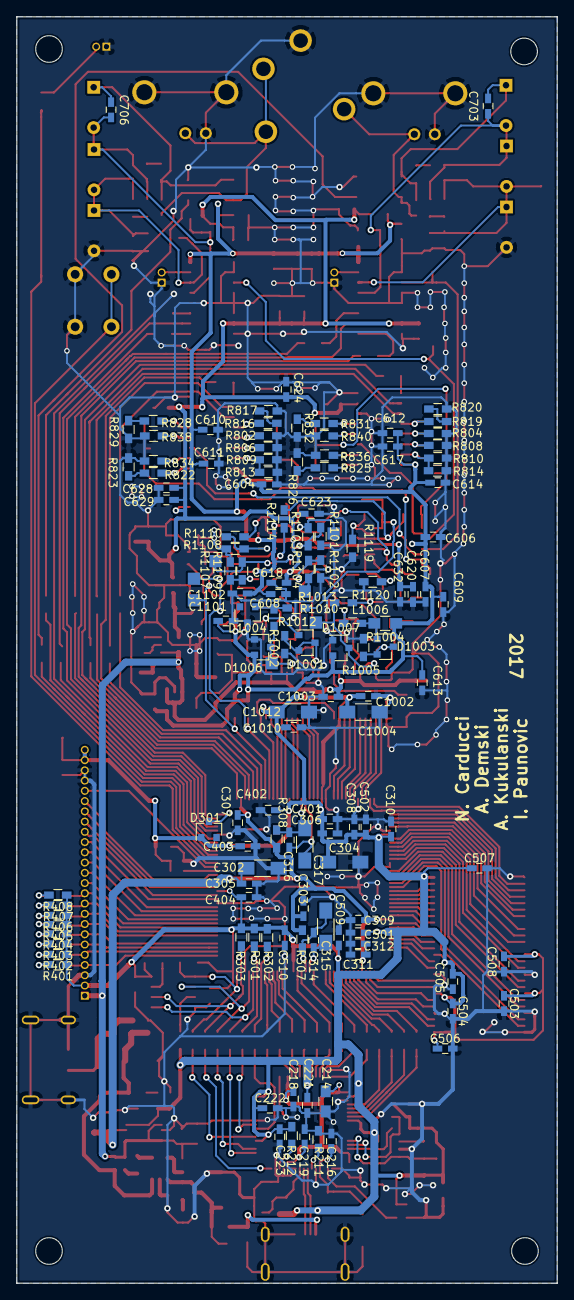
[picture p12: board iCE40hxk4_dev_board.kicad_pcb from below]

Board: 4 copper layers, 67.0 x 157.0 mm, 383 parts (133 on the bottom side), 266 nets.

Parts:
C201, C204, C206, C208, C209, C216, C217, C218, C219, C220, C221, C222, C223, C224, C301, C305, C307, C308, C309, C311, C313, C314, C316, C401, C402, C403, C404, C405, C407, C501, C502, C503, C504, C505, C506, C507, C508, C509, C510, C601, C603, C605, C606, C608, C612, C614, C616, C618, C619, C621, C623, C625, C627, C629, C631, C633, C635, C905, C1002, C1003, C1005, C1006, C1010, C1011, C1018, C1101, C1102: 100nF; C_0603_HandSoldering
C202, C203, C310, C312: 10nF; C_0603_HandSoldering
C205, C207, C213, C215: 4.7uF; C_1206_HandSoldering
C210, C211, C212: 2.2uF; C_0805_HandSoldering
C214: 4.7uF; C_0805_HandSoldering
C302, C304, C315, C317, C907, C1001, C1004, C1007, C1008, C1009, C1012, C1013, C1014, C1015, C1016, C1017: 10uF; C_1206_HandSoldering
C303, C306, C602, C604, C607, C609, C611, C613, C615, C617, C622, C624, C626, C628, C630, C632, C634, C636, C903, C904, C906: 1uF; C_0603_HandSoldering
C610, C620, C901, C902: 10uF; C_0603_HandSoldering
C701, C702: 100pF; C_0603_HandSoldering
C703, C706: 22pF; C_0603_HandSoldering
C704, C707: 1-3pF; CP_Radial_Tantal_D6.0mm_P5.00mm
C705, C708: 5-20pF; CP_Radial_Tantal_D6.0mm_P5.00mm
C709, C711: 180pF; C_0603_HandSoldering
C710, C712: 1800pF; C_0603_HandSoldering
C713, C714: Not used; CP_Radial_Tantal_D6.0mm_P5.00mm
D201, D208: D_Schottky_CDBURT0530LL-HF; D_0603
D202, D204, D401, D402, D403, D404, D405, D406, D407, D408: GREEN; LED_0603
D203: RED; LED_0603
D301: D_BAS21,215; D_SOT-23_ANK
D701, D702, D1006, D1007: D_Schottky_BAT54S-7-F; SOT-23
D1001, D1003: LM4040DYM3-2.5-TR; SOT-23
D1002: LM4041EIM3-1.2/NOPB; SOT-23
D1004, D1005: D_Schottky_BAT54-7-F; D_SOT-23_ANK
J101, J601, J602: CONN_01X02; Pin_Header_Straight_1x02_Pitch1.27mm
J102: Jack Estereo; KobiConn_161-3509-E_Jack_3.5mm
J103, J104: CONN_COAXIAL; BNC_1-1337543-0
J105, J106, J107, J108: MountingHole
J202: USB_OTG; USB_Micro-B_47642-0001
J401, J402, J403, J404, J405, J406, J501, J502, J603, J604, J605, J701, J702, J705, J706, J801, J802, J803, J804, J805, J806, J807, J808, J809, J810, J1001, J1002, J1003, J1004: Testpoint; TestPoint
J1005: USB_EXT; USB_Micro-B_47642-0001
J1101: CONN_01X25; Pin_Header_Straight_1x25_Pitch1.27mm
L201, L202, L203, L204: L_BLM18BA750SZ1D; L_0603_HandSoldering
L1001, L1002, L1003, L1004, L1005, L1006, L1007: L_BLM18AG121SN1D; L_0603_HandSoldering
R101, R201, R207, R209, R210, R301, R302, R303, R304, R305, R306, R704, R708, R1105, R1106, R1107, R1108, R1109, R1110: 10K; R_0603_HandSoldering
R202, R204, R205: 1K5; R_0603_HandSoldering
R208, R829, R832: 2K2; R_0603_HandSoldering
R211: 12K; R_0603_HandSoldering
R212, R309, R310, R311, R312, R313, R314, R315, R316, R317, R318, R319, R320, R321, R322, R827, R830, R1115, R1118: 1K; R_0603_HandSoldering
R213, R214, R215, R216, R217, R218, R219, R220, R221, R222, R223, R224, R225, R226, R227, R228, R229, R230, R231, R709, R710, R801, R803, R1002, R1005, R1103, R1104: 0R; R_0603_HandSoldering
R307, R308, R821, R823, R824, R826: 100R; R_0603_HandSoldering
R401, R402, R403, R404, R405, R406, R407, R408: 680R; R_0603_HandSoldering
R701, R705: 13K; R_0603_HandSoldering
R702, R706: 887K; R_0603_HandSoldering
R703, R707: 90K9; R_0603_HandSoldering
R802, R804, R1101, R1102: Let it open; R_0603_HandSoldering
R805, R806, R807, R808, R1010, R1011: 470R; R_0603_HandSoldering
R809, R810, R813, R814, R816, R819, R822, R825: 1K8; R_0603_HandSoldering
R811, R812, R815, R817, R818, R820, R1003, R1012, R1013: 220R; R_0603_HandSoldering
R828, R831: 47K; R_0603_HandSoldering
R833, R834, R835, R836, R837, R838, R839, R840: Not used; R_0603_HandSoldering
R1001, R1004: 50R; R_0805_HandSoldering
R1006, R1007, R1008, R1009, R1113, R1116: 4K7; R_0603_HandSoldering
R1111, R1112: 330R; R_0603_HandSoldering
R1114, R1117: 1K2; R_0603_HandSoldering
R1119, R1120: 6K8; R_0603_HandSoldering
R1121, R1122: 62K; R_0603_HandSoldering
SW1101: SW_Push; SW_PUSH_6mm_h4.3mm
U201: MIC2005A-2YM5; SOT-23-5_HandSoldering
U203: 93LC56BT-I/OT; SOT-23-6_Handsoldering
U204: MIC5355-S4YMME; MSOP-8_3x3mm_Pitch0.65mm
U205: FT2232H; LQFP-64_10x10mm_Pitch0.5mm
U301: iCE40-HX4K-TQ144; LQFP-144_20x20mm_Pitch0.5mm
U302: FLASH 2Mb; SOIC-8_3.9x4.9mm_Pitch1.27mm
U501: AS4C1M16S-7TCN; TSOP50-II
U701, U702: CPC1017N; 2.54SOP4
U703, U704, U801, U802: CD4051BM96; SOIC-16_3.9x9.9mm_Pitch1.27mm
U803: TLV3544IPWR; TSSOP-14_4.4x5mm_Pitch0.65mm
U901: LM2776DBVR; SOT-23-6
U902: MIC5317-2.5YM5-TR; SC-74(5-pins)
U903: TPS72325DBVR; SOT-23-5
U1001, U1002: ADC1175; TSSOP-24_4.4x7.8mm_Pitch0.65mm
U1101, U1102, U1105, U1106: MIC7300; SOT-23-5
U1103, U1104: MCP4716; SOT-23-6
Xtal201, Xtal401: LFSPXO019966; VLGA_4_2.5x2.0mm

Connections:
+1.8V: C214.1, C218.1, C219.1, C220.1, U205.12, U205.37, U205.49, U205.64
+3V3: C201.1, C209.1, C212.1, C221.1, C222.1, C223.1, C224.1, C301.1, C304.1, C306.1, C308.1, C310.1, C313.1, C401.1, C402.1, C403.1, C404.1, C405.1, C407.1, C501.1, C502.1, C503.1, C504.1, C505.1, C506.1, C507.1, C508.1, C509.1, C510.1, C1002.2, C1004.1, C1010.2, C1012.1, D301.2, J1004.1, J1101.2, J1101.24, J1101.25, L203.1, L204.1, R207.1, R209.1, R210.1, R212.2, R301.1, R302.1, R303.1, R304.1, R305.1, R306.1, R401.1, R402.1, R403.1, R404.1, R405.1, R406.1, R407.1, R408.1, U203.6, U204.8, U205.20, U205.31, U205.42, U205.50, U205.56, U301.6, U301.30, U301.46, U301.57, U301.72, U301.89, U301.100, U301.123, U301.131, U302.8, U501.1, U501.7, U501.13, U501.25, U501.38, U501.44, U1001.11, U1002.11, Xtal201.1, Xtal201.4, Xtal401.1, Xtal401.4
+5V: C208.1, C210.1, C901.1, C905.1, C1001.1, C1003.2, C1009.1, C1011.2, D201.1, D203.2, D208.1, J1101.1, L1001.1, L1002.1, U204.1, U204.4, U204.5, U901.3, U901.4, U902.1, U902.3, U1001.14, U1001.15, U1001.18, U1002.14, U1002.15, U1002.18
/Analog front end/-5V: C902.1, C904.2, J603.1, U901.1, U903.5
/Analog front end/ADC/5V0_D1: C1005.2, C1007.1, L1001.2, U1001.13
/Analog front end/ADC/5V0_D2: C1006.2, C1008.1, L1002.2, U1002.13
/Analog front end/ADC/CHA_V_REF_BOTTOM: C1016.2, C1017.1, L1007.2, R1009.1, U1001.23
/Analog front end/ADC/CHA_V_REF_TOP: C1016.1, J702.1, L1006.2, R1008.2, U1001.17
/Analog front end/ADC/CHB_V_REF_BOTTOM: C1013.2, C1014.1, L1004.2, R1007.1, U1002.23
/Analog front end/ADC/CHB_V_REF_TOP: C1013.1, J701.1, L1003.2, R1006.2, U1002.17
/Analog front end/ADC_CLK: U301.119, U1001.12, U1002.12
/Analog front end/ATTENUATION/CHA_ATT_20dB: C703.2, C704.1, C709.1, C714.2, D701.3, J403.1, R702.2, R703.1, U703.13
/Analog front end/ATTENUATION/CHA_ATT_40dB: C704.2, C705.1, C709.2, C710.1, J404.1, R704.1, R710.1, U703.14
/Analog front end/ATTENUATION/CHA_ATT_SEL_0: R309.1, U703.11
/Analog front end/ATTENUATION/CHA_ATT_SEL_1: R310.1, U703.10
/Analog front end/ATTENUATION/CHA_ATT_SEL_2: R311.1, U703.9
/Analog front end/ATTENUATION/CHA_DC_COUPLING: R315.1, U701.1
/Analog front end/ATTENUATION/CHB_ATT_20dB: C706.2, C707.1, C711.1, C713.2, D702.3, J402.1, R706.2, R707.1, U704.13
/Analog front end/ATTENUATION/CHB_ATT_40dB: C707.2, C708.1, C711.2, C712.1, J401.1, R708.1, R709.1, U704.14
/Analog front end/ATTENUATION/CHB_ATT_SEL_0: R312.1, U704.11
/Analog front end/ATTENUATION/CHB_ATT_SEL_1: R313.1, U704.10
/Analog front end/ATTENUATION/CHB_ATT_SEL_2: R314.1, U704.9
/Analog front end/ATTENUATION/CHB_DC_COUPLING: R316.1, U702.1
/Analog front end/CHA_ATT_OUT: J405.1, U703.3, U803.5
/Analog front end/CHA_ATT_SEL_0: R309.2, U301.105
/Analog front end/CHA_ATT_SEL_1: R310.2, U301.106
/Analog front end/CHA_ATT_SEL_2: R311.2, U301.107
/Analog front end/CHA_DAC: J804.1, U1104.1, U1106.3
/Analog front end/CHA_DC_COUPLING: R315.2, U301.98
/Analog front end/CHA_GAIN_SEL_0: R317.2, U301.116
/Analog front end/CHA_GAIN_SEL_1: R318.2, U301.115
/Analog front end/CHA_GAIN_SEL_2: R319.2, U301.114
/Analog front end/CHA_OFFSET: J806.1, R1110.1, R1117.2, U1106.1
/Analog front end/CHA_OFFSET_OUT: J808.1, R1011.2, R1122.1, U803.8
/Analog front end/CHA_PGA_OUT: J501.1, R801.2, R805.1, R811.1, R815.1, R821.1, R827.1, R833.1, R837.1, R1118.2, U803.7
/Analog front end/CHA_VREF_CENT: R1008.1, R1009.2, U1101.3
/Analog front end/CHB_ATT_OUT: J406.1, U704.3, U803.3
/Analog front end/CHB_ATT_SEL_0: R312.2, U301.101
/Analog front end/CHB_ATT_SEL_1: R313.2, U301.102
/Analog front end/CHB_ATT_SEL_2: R314.2, U301.104
/Analog front end/CHB_DAC: J803.1, U1103.1, U1105.3
/Analog front end/CHB_DC_COUPLING: R316.2, U301.99
/Analog front end/CHB_GAIN_SEL_0: R320.2, U301.113
/Analog front end/CHB_GAIN_SEL_1: R321.2, U301.112
/Analog front end/CHB_GAIN_SEL_2: R322.2, U301.110
/Analog front end/CHB_OFFSET: J805.1, R1109.1, R1114.2, U1105.1
/Analog front end/CHB_OFFSET_OUT: J807.1, R1010.2, R1121.1, U803.14
/Analog front end/CHB_PGA_OUT: J502.1, R803.2, R807.1, R812.1, R818.1, R824.1, R830.1, R835.1, R839.1, R1115.2, U803.1
/Analog front end/CHB_VREF_CENT: R1006.1, R1007.2, U1102.3
/Analog front end/OFFSET/CHA_V_OFFSET_FIJO: J802.1, R1103.1, R1112.2, U1101.1
/Analog front end/OFFSET/CHB_V_OFFSET_FIJO: J801.1, R1104.1, R1111.2, U1102.1
/Analog front end/PGA/CHA_G0: R801.1, R802.2, U801.13
/Analog front end/PGA/CHA_G1: R805.2, R806.1, U801.14
/Analog front end/PGA/CHA_G2: R809.1, R811.2, R813.1, U801.15
/Analog front end/PGA/CHA_G3: R815.2, R816.2, U801.12
/Analog front end/PGA/CHA_G4: R821.2, R822.1, U801.1
/Analog front end/PGA/CHA_G5: R827.2, R828.1, U801.5
/Analog front end/PGA/CHA_G6: R833.2, R834.1, U801.2
/Analog front end/PGA/CHA_G7: R837.2, R838.1, U801.4
/Analog front end/PGA/CHA_GAIN_SEL_0: R317.1, U801.11
/Analog front end/PGA/CHA_GAIN_SEL_1: R318.1, U801.10
/Analog front end/PGA/CHA_GAIN_SEL_2: R319.1, U801.9
/Analog front end/PGA/CHB_G0: R803.1, R804.2, U802.13
/Analog front end/PGA/CHB_G1: R807.2, R808.1, U802.14
/Analog front end/PGA/CHB_G2: R810.1, R812.2, R814.1, U802.15
/Analog front end/PGA/CHB_G3: R818.2, R819.2, U802.12
/Analog front end/PGA/CHB_G4: R824.2, R825.2, U802.1
/Analog front end/PGA/CHB_G5: R830.2, R831.1, U802.5
/Analog front end/PGA/CHB_G6: R835.2, R836.1, U802.2
/Analog front end/PGA/CHB_G7: R839.2, R840.1, U802.4
/Analog front end/PGA/CHB_GAIN_SEL_0: R320.1, U802.11
/Analog front end/PGA/CHB_GAIN_SEL_1: R321.1, U802.10
/Analog front end/PGA/CHB_GAIN_SEL_2: R322.1, U802.9
/Analog front end/VDD_A: C601.2, C602.2, C603.2, C604.2, C605.2, C606.2, C607.2, C608.2, C609.2, C610.1, C611.2, C612.2, C613.2, C614.2, C615.2, C616.2, C617.2, C619.2, C906.1, C1101.2, C1102.2, D701.2, D702.2, D1006.2, D1007.2, J604.1, R1001.1, R1003.2, R1004.1, R1105.1, R1106.1, U703.16, U704.16, U801.16, U802.16, U803.4, U902.5, U1101.5, U1102.5, U1103.3, U1104.3, U1105.5, U1106.5
/Analog front end/VSS_A: C618.2, C620.1, C621.2, C622.2, C623.2, C624.2, C625.2, C626.2, C627.2, C628.2, C629.2, C630.2, C631.2, C632.2, C633.2, C634.2, C635.2, C636.2, C907.2, D701.1, D702.1, J605.1, U703.7, U704.7, U801.7, U802.7, U803.11, U903.4, U1101.2, U1102.2, U1105.2, U1106.2
/Analog front end/V_REF_DAC: C1015.1, C1018.2, L1005.2, R1107.2, R1108.2, U1103.6, U1104.6
/CHA: C701.2, J102.2, J104.1, U701.4
/CHB: C702.2, J102.3, J102.4, J103.1, U702.4
/FPGA_PROGRAMMING+POWER/+1.2V: C211.1, C302.1, C303.1, C305.1, C307.1, C309.1, C311.1, C312.1, J1003.1, R307.1, R308.1, U204.7, U301.27, U301.40, U301.92, U301.111
/FPGA_PROGRAMMING+POWER/CDONE: R217.1, R302.2, U301.65
/FPGA_PROGRAMMING+POWER/CRESET: R218.1, R301.2, U301.66
/FPGA_PROGRAMMING+POWER/MISO: R215.1, U301.68, U302.2
/FPGA_PROGRAMMING+POWER/MOSI: R214.1, U301.67, U302.5
/FPGA_PROGRAMMING+POWER/SCK: R213.1, R303.2, U301.70, U302.6
/FPGA_PROGRAMMING+POWER/SS: R216.1, R306.2, U301.71, U302.1
/RAM+LEFT_BOTTOM_BANKs/A0: U301.23, U501.21
/RAM+LEFT_BOTTOM_BANKs/A1: U301.22, U501.22
/RAM+LEFT_BOTTOM_BANKs/A2: U301.21, U501.23
/RAM+LEFT_BOTTOM_BANKs/A3: U301.20, U501.24
/RAM+LEFT_BOTTOM_BANKs/A4: U301.144, U501.27
/RAM+LEFT_BOTTOM_BANKs/A5: U301.143, U501.28
/RAM+LEFT_BOTTOM_BANKs/A6: U301.1, U501.29
/RAM+LEFT_BOTTOM_BANKs/A7: U301.2, U501.30
/RAM+LEFT_BOTTOM_BANKs/A8: U301.3, U501.31
/RAM+LEFT_BOTTOM_BANKs/A9: U301.4, U501.32
/RAM+LEFT_BOTTOM_BANKs/A10: U301.24, U501.20
/RAM+LEFT_BOTTOM_BANKs/A11: U301.25, U501.19
/RAM+LEFT_BOTTOM_BANKs/CKE: U301.7, U501.34
/RAM+LEFT_BOTTOM_BANKs/CLK: U301.8, U501.35
/RAM+LEFT_BOTTOM_BANKs/D0: R219.1, U301.64
/RAM+LEFT_BOTTOM_BANKs/D1: R220.1, U301.63
/RAM+LEFT_BOTTOM_BANKs/D2: R221.1, U301.62
/RAM+LEFT_BOTTOM_BANKs/D3: R222.1, U301.61
/RAM+LEFT_BOTTOM_BANKs/D4: R223.1, U301.60
/RAM+LEFT_BOTTOM_BANKs/D5: R224.1, U301.56
/RAM+LEFT_BOTTOM_BANKs/D6: R225.1, U301.55
/RAM+LEFT_BOTTOM_BANKs/D7: R226.1, U301.52
/RAM+LEFT_BOTTOM_BANKs/DQ0: U301.43, U501.2
/RAM+LEFT_BOTTOM_BANKs/DQ1: U301.42, U501.3
/RAM+LEFT_BOTTOM_BANKs/DQ2: U301.41, U501.5
/RAM+LEFT_BOTTOM_BANKs/DQ3: U301.39, U501.6
/RAM+LEFT_BOTTOM_BANKs/DQ4: U301.38, U501.8
/RAM+LEFT_BOTTOM_BANKs/DQ5: U301.37, U501.9
/RAM+LEFT_BOTTOM_BANKs/DQ6: U301.34, U501.11
/RAM+LEFT_BOTTOM_BANKs/DQ7: U301.33, U501.12
/RAM+LEFT_BOTTOM_BANKs/DQ8: U301.10, U501.39
/RAM+LEFT_BOTTOM_BANKs/DQ9: U301.11, U501.40
/RAM+LEFT_BOTTOM_BANKs/DQ10: U301.12, U501.42
/RAM+LEFT_BOTTOM_BANKs/DQ11: U301.15, U501.43
/RAM+LEFT_BOTTOM_BANKs/DQ12: U301.16, U501.45
/RAM+LEFT_BOTTOM_BANKs/DQ13: U301.17, U501.46
/RAM+LEFT_BOTTOM_BANKs/DQ14: U301.18, U501.48
/RAM+LEFT_BOTTOM_BANKs/DQ15: U301.19, U501.49
/RAM+LEFT_BOTTOM_BANKs/LDQM: U301.32, U501.14
/RAM+LEFT_BOTTOM_BANKs/SIWU: R231.1, U301.44
/RAM+LEFT_BOTTOM_BANKs/UDQM: U301.9, U501.36
/RAM+LEFT_BOTTOM_BANKs/~CAS: U301.29, U501.16
/RAM+LEFT_BOTTOM_BANKs/~CS: U301.26, U501.18
/RAM+LEFT_BOTTOM_BANKs/~RAS: U301.28, U501.17
/RAM+LEFT_BOTTOM_BANKs/~RD: R229.1, U301.47
/RAM+LEFT_BOTTOM_BANKs/~RXF: R227.1, U301.49
/RAM+LEFT_BOTTOM_BANKs/~TXE: R228.1, U301.48
/RAM+LEFT_BOTTOM_BANKs/~WE: U301.31, U501.15
/RAM+LEFT_BOTTOM_BANKs/~WR: R230.1, U301.45
/RIGHT_TOP_BANKs/ADC_0: U301.120, U1002.10
/RIGHT_TOP_BANKs/ADC_1: U301.121, U1002.9
/RIGHT_TOP_BANKs/ADC_2: U301.122, U1002.8
/RIGHT_TOP_BANKs/ADC_3: U301.124, U1002.7
/RIGHT_TOP_BANKs/ADC_4: U301.125, U1002.6
/RIGHT_TOP_BANKs/ADC_5: U301.128, U1002.5
/RIGHT_TOP_BANKs/ADC_6: U301.129, U1002.4
/RIGHT_TOP_BANKs/ADC_7: U301.130, U1002.3
/RIGHT_TOP_BANKs/ADC_8: U301.134, U1001.10
/RIGHT_TOP_BANKs/ADC_9: U301.135, U1001.9
/RIGHT_TOP_BANKs/ADC_10: U301.136, U1001.8
/RIGHT_TOP_BANKs/ADC_11: U301.137, U1001.7
/RIGHT_TOP_BANKs/ADC_12: U301.138, U1001.6
/RIGHT_TOP_BANKs/ADC_13: U301.139, U1001.5
/RIGHT_TOP_BANKs/ADC_14: U301.141, U1001.4
/RIGHT_TOP_BANKs/ADC_15: U301.142, U1001.3
/RIGHT_TOP_BANKs/IOR_109: D401.1, J1101.4, U301.73
/RIGHT_TOP_BANKs/IOR_110: D402.1, J1101.5, U301.74
/RIGHT_TOP_BANKs/IOR_111: D403.1, J1101.6, U301.75
/RIGHT_TOP_BANKs/IOR_112: D404.1, J1101.7, U301.76
/RIGHT_TOP_BANKs/IOR_114: D405.1, J1101.8, U301.78
/RIGHT_TOP_BANKs/IOR_115: D406.1, J1101.9, U301.79
/RIGHT_TOP_BANKs/IOR_116: D407.1, J1101.10, U301.80
/RIGHT_TOP_BANKs/IOR_117: D408.1, J1101.11, U301.81
/RIGHT_TOP_BANKs/IOR_118: J1101.12, U301.82
/RIGHT_TOP_BANKs/IOR_119: J1101.13, U301.83
/RIGHT_TOP_BANKs/IOR_120: J1101.14, U301.84
/RIGHT_TOP_BANKs/IOR_128: J1101.15, U301.85
/RIGHT_TOP_BANKs/IOR_136: J1101.16, U301.87
/RIGHT_TOP_BANKs/IOR_137: J1101.17, U301.88
/RIGHT_TOP_BANKs/IOR_138: J1101.18, U301.90
/RIGHT_TOP_BANKs/IOR_139: J1101.19, U301.91
/RIGHT_TOP_BANKs/IOR_140: J1101.20, U301.93
/RIGHT_TOP_BANKs/IOR_144: J1101.21, U301.95
/RIGHT_TOP_BANKs/IOT_146: R101.1, U301.96
/RIGHT_TOP_BANKs/IOT_174: J809.1, R1105.2, U301.117, U1103.5, U1104.5
/RIGHT_TOP_BANKs/IOT_177: J810.1, R1106.2, U301.118, U1103.4, U1104.4
/RIGHT_TOP_BANKs/OSC: U301.94, Xtal401.3
/USB+OSCILLATOR+REGULATOR/D+: J202.3, U205.8
/USB+OSCILLATOR+REGULATOR/D-: J202.2, U205.7
/USB+OSCILLATOR+REGULATOR/EECLK: R209.2, U203.4, U205.62
/USB+OSCILLATOR+REGULATOR/EECS: R207.2, U203.5, U205.63
/USB+OSCILLATOR+REGULATOR/EEDATA: R208.1, R210.2, U203.3, U205.61
/USB+OSCILLATOR+REGULATOR/Vbus_filtered: C206.1, C207.1, J1002.1, L202.2, R204.2, U201.1
/USB+OSCILLATOR+REGULATOR/Vext_filtered: C204.1, C205.1, D201.2, J1001.1, L201.2, R201.1, R202.1, U201.3
GND: C201.2, C202.2, C203.2, C204.2, C205.2, C206.2, C207.2, C208.2, C209.2, C210.2, C211.2, C212.2, C213.2, C214.2, C215.2, C216.2, C217.2, C218.2, C219.2, C220.2, C221.2, C222.2, C223.2, C224.2, C301.2, C302.2, C303.2, C304.2, C305.2, C306.2, C307.2, C308.2, C309.2, C310.2, C311.2, C312.2, C313.2, C401.2, C402.2, C403.2, C404.2, C405.2, C407.2, C501.2, C502.2, C503.2, C504.2, C505.2, C506.2, C507.2, C508.2, C509.2, C510.2, C601.1, C602.1, C603.1, C604.1, C605.1, C606.1, C607.1, C608.1, C609.1, C610.2, C611.1, C612.1, C613.1, C614.1, C615.1, C616.1, C617.1, C618.1, C619.1, C620.2, C621.1, C622.1, C623.1, C624.1, C625.1, C626.1, C627.1, C628.1, C629.1, C630.1, C631.1, C632.1, C633.1, C634.1, C635.1, C636.1, C705.2, C708.2, C710.2, C712.2, C901.2, C902.2, C904.1, C905.2, C906.2, C907.1, C1001.2, C1002.1, C1003.1, C1004.2, C1005.1, C1006.1, C1007.2, C1008.2, C1009.2, C1010.1, C1011.1, C1012.2, C1014.2, C1015.2, C1017.2, C1018.1, C1101.1, C1102.1, D202.1, D204.1, D1002.2, D1002.3, D1004.1, D1005.1, D1006.1, D1007.1, J101.1, J102.1, J103.2, J104.2, J202.5, J202.6, J601.1, J602.1, J1005.5, J1005.6, J1101.3, J1101.22, J1101.23, R201.2, R211.2, R704.2, R708.2, R802.1, R804.1, R806.2, R808.2, R809.2, R810.2, R813.2, R814.2, R817.2, R820.2, R823.2, R826.2, R829.2, R832.2, R834.2, R836.2, R838.2, R840.2, R1002.1, R1005.1, R1101.2, R1102.2, R1119.2, R1120.2, SW1101.2, U201.2, U203.2, U204.2, U205.1, U205.5, U205.10, U205.11, U205.13, U205.15, U205.25, U205.35, U205.47, U205.51, U301.5, U301.13, U301.14, U301.59, U301.69, U301.86, U301.103, U301.132, U301.140, U302.4, U501.4, U501.10, U501.26, U501.41, U501.47, U501.50, U701.2, U702.2, U703.1, U703.2, U703.4, U703.5, U703.6, U703.8, U703.12, U704.1, U704.2, U704.4, U704.5, U704.6, U704.8, U704.12, U801.6, U801.8, U802.6, U802.8, U901.2, U902.2, U903.2, U1001.1, U1001.2, U1001.20, U1001.21, U1001.24, U1002.1, U1002.2, U1002.20, U1002.21, U1002.24, U1103.2, U1104.2, Xtal201.2, Xtal401.2
unnamed: C202.1, J1005.1, L201.1
unnamed: C203.1, J202.1, L202.1
unnamed: C213.1, C216.1, L204.2, U205.4
unnamed: C215.1, C217.1, L203.2, U205.9
unnamed: C314.1, C315.1, R307.2, U301.54
unnamed: C314.2, C315.2, U301.53
unnamed: C316.1, C317.1, R308.2, U301.126
unnamed: C316.2, C317.2, U301.127
unnamed: C701.1, C703.1, C714.1, R701.1, U701.3
unnamed: C702.1, C706.1, C713.1, R705.1, U702.3
unnamed: C903.1, U901.5
unnamed: C903.2, U901.6
unnamed: D202.2, R202.2
unnamed: D203.1, R205.1
unnamed: D204.2, R204.1
unnamed: D208.2, U201.5
unnamed: D301.1, U301.108
unnamed: D401.2, R401.2
unnamed: D402.2, R402.2
unnamed: D403.2, R403.2
unnamed: D404.2, R404.2
unnamed: D405.2, R405.2
unnamed: D406.2, R406.2
unnamed: D407.2, R407.2
unnamed: D408.2, R408.2
unnamed: D1001.1, L1003.1, R1001.2
unnamed: D1001.2, D1001.3, L1004.1, R1002.2
unnamed: D1002.1, L1005.1, R1003.1
unnamed: D1003.1, L1006.1, R1004.2
unnamed: D1003.2, D1003.3, L1007.1, R1005.2
unnamed: D1004.2, R1010.1, R1012.2
unnamed: D1005.2, R1011.1, R1013.2
unnamed: D1006.3, J705.1, R1012.1, U1002.19
unnamed: D1007.3, J706.1, R1013.1, U1001.19
unnamed: J101.2, R101.2
unnamed: J601.2, U703.15
unnamed: J602.2, U704.15
unnamed: R205.2, U201.4
unnamed: R208.2, U203.1
unnamed: R211.1, U205.6
unnamed: R212.1, U205.14
unnamed: R213.2, U205.16
unnamed: R214.2, U205.17
unnamed: R215.2, U205.18
unnamed: R216.2, U205.21
unnamed: R217.2, U205.23
unnamed: R218.2, U205.24
unnamed: R219.2, U205.38
unnamed: R220.2, U205.39
unnamed: R221.2, U205.40
unnamed: R222.2, U205.41
unnamed: R223.2, U205.43
unnamed: R224.2, U205.44
unnamed: R225.2, U205.45
unnamed: R226.2, U205.46
unnamed: R227.2, U205.48
unnamed: R228.2, U205.52
unnamed: R229.2, U205.53
unnamed: R230.2, U205.54
unnamed: R231.2, U205.55
unnamed: R304.2, U302.3
unnamed: R305.2, U302.7
unnamed: R701.2, R702.1
unnamed: R703.2, R710.2
unnamed: R705.2, R706.1
unnamed: R707.2, R709.2
unnamed: R816.1, R817.1
unnamed: R819.1, R820.1
unnamed: R822.2, R823.1
unnamed: R825.1, R826.1
unnamed: R828.2, R829.1
unnamed: R831.2, R832.1
unnamed: R1101.1, R1103.2, U1101.4
unnamed: R1102.1, R1104.2, U1102.4
unnamed: R1107.1, R1109.2, U1105.4
unnamed: R1108.1, R1110.2, U1106.4
unnamed: R1111.1, R1113.2
unnamed: R1112.1, R1116.2
unnamed: R1113.1, R1114.1, R1115.1, U803.12
unnamed: R1116.1, R1117.1, R1118.1, U803.10
unnamed: R1119.1, R1121.2, U803.13
unnamed: R1120.1, R1122.2, U803.9
unnamed: SW1101.1, U301.97
unnamed: U205.2, Xtal201.3
unnamed: U801.3, U803.6
unnamed: U802.3, U803.2
