smartbench/mainboard/(commit log)

2017-03-30 Commit inicial. Agregado esquematico tentativo
    [BANKS+HEADERS.sch, FPGA_PROGRAMMING+POWER.sch, USB+OSCILLATOR+REGULATOR.sch, USB_PROGRAMMER_AND_FIFO_IO.sch, iCE40hxk4_dev_board.kicad_pcb, iCE40hxk4_dev_board.sch]
2017-03-31 Agregada alimentacion externa y seleccion entre bus/self powered. Agregado buffer distribucion clock
    [BANKS+HEADERS.sch, FPGA_PROGRAMMING+POWER.sch, USB+OSCILLATOR+REGULATOR.sch, iCE40hxk4_dev_board.sch]
2017-03-31 Agregando DRAM...
    [BANKS+HEADERS.sch, FPGA_PROGRAMMING+POWER.sch, RAM.sch, USB+OSCILLATOR+REGULATOR.sch, iCE40hxk4_dev_board.sch]
2017-03-31 Minor fixes and the gitignore was removed
    [FPGA_PROGRAMMING+POWER.sch, RAM.sch, USB+OSCILLATOR+REGULATOR.sch]
2017-04-04 Reordered IO connections to FPGA
    [BANKS+HEADERS.sch, RAM.sch, USB_PROGRAMMER_AND_FIFO_IO.sch]
2017-04-06 Added part numbers of sheet USB+...
    [USB+OSCILLATOR+REGULATOR.sch]
2017-04-07 Added part number and specifications on all sheets
    [BANKS+HEADERS.sch, FPGA_PROGRAMMING+POWER.sch, RAM.sch]
2017-04-09 Reordered connections again. Option 1: RAM at left bank, some connections at left and top banks.
    [BANKS+HEADERS.sch, FPGA_PROGRAMMING+POWER.sch, RAM+LEFT_BOTTOM_BANKs.sch, RAM.sch, RIGHT_TOP_BANKs.sch, iCE40hxk4_dev_board.sch]
2017-04-17 The schematic is now free of any ERC error. Not connected and power flags added. No more global power pins, hierarchical labels used for power connections. TODO list: -Check if all footpritns are alr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
    [FPGA_PROGRAMMING+POWER.sch, RAM+LEFT_BOTTOM_BANKs.sch, RIGHT_TOP_BANKs.sch, USB+OSCILLATOR+REGULATOR.sch, iCE40hxk4_dev_board.sch]
2017-04-18 First netlist export
    [FPGA_PROGRAMMING+POWER.sch, RAM+LEFT_BOTTOM_BANKs.sch, RIGHT_TOP_BANKs.sch, USB+OSCILLATOR+REGULATOR.sch, iCE40hxk4_dev_board.kicad_pcb]
2017-04-20 Added three indicator LEDs. Two green leds, one indicating if usb power is connected, and the other one indicating if the external power source is connected. One red led indicating if fault condition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
    [USB+OSCILLATOR+REGULATOR.sch]
2017-04-21 Fist approach of board placement
    [RIGHT_TOP_BANKs.sch, USB+OSCILLATOR+REGULATOR.sch, iCE40hxk4_dev_board.kicad_pcb]
2017-04-21 Clk's buffers were removed and pcb routing was started
    [FPGA_PROGRAMMING+POWER.sch, RIGHT_TOP_BANKs.sch, USB+OSCILLATOR+REGULATOR.sch, iCE40hxk4_dev_board.kicad_pcb, iCE40hxk4_dev_board.sch]
2017-04-22 Front-end first commit
    [etapa_analogica.kicad_pcb, etapa_analogica.sch]
2017-04-23 Agregados MPN,datasheet a librerías existentes. Creadas librerías con array de diodos schottky, muxes 8:1 y solid state relay. Pines de alimentación de mux puestos visibles. Cambiada posición de C va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
    [etapa_analogica.sch]
2017-04-24 Separando en bloques, completando etapa de atenuación, de ganacia variable, de offset y entrada al adc.
    [ADC.sch, Attenuation.sch, Offset.sch, PGA.sch, etapa_analogica.sch]
2017-04-25 Agregada una protección para la entrada del ADC. Etapa de offset modificada. REVISAR (just in case ...).
    [ADC.sch, Attenuation.sch, Offset.sch, etapa_analogica.sch]
2017-05-07 Placing de algunos capas de acople y otras giladas
    [USB+OSCILLATOR+REGULATOR.sch, iCE40hxk4_dev_board.kicad_pcb]
2017-05-09 Agregados reguladores fuente alimentación. Agregados varios labels. * El regulador negativo es de -3V (en vez de -3.3V). Why? Money. to do next: referencias de tensión.
    [ADC.sch, Attenuation.sch, Offset.sch, PGA.sch, etapa_analogica.sch, powerSupply.sch]
2017-05-10 Agregados reguladores de tensión 2.5V (LM4040) y 1.225V (LM4041). todo: filtro Vref todo: Circuito DAC
    [ADC.sch, Attenuation.sch, Offset.sch, PGA.sch, etapa_analogica.sch, powerSupply.sch]
2017-05-12 Cambios menores
    [ADC.sch, Attenuation.sch, Offset.sch, PGA.sch, etapa_analogica.sch, powerSupply.sch]
2017-05-13 Changed MC2005 led fault, because it's an active low output and it's not active high. Placing of some capacitors and resistors. Check if it's possible to power the fpga in two layers (both 3.3 and 1.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
    [USB+OSCILLATOR+REGULATOR.sch, iCE40hxk4_dev_board.kicad_pcb]
2017-05-14 cambio referencia adc (doble)
    [ADC.sch, Attenuation.sch, Offset.sch, PGA.sch, etapa_analogica.sch, powerSupply.sch]
2017-05-14 Cambiado en inversor por uno de 200mA, así como sus respectivos capacitores. Falta: DAC Falta: elegir modelo capacitores
    [ADC.sch, powerSupply.sch]
2017-05-25 Continued with routing....
    [USB+OSCILLATOR+REGULATOR.sch, iCE40hxk4_dev_board.kicad_pcb]
2017-05-26 Continued with routing...
    [iCE40hxk4_dev_board.kicad_pcb]
2017-05-27 Replacement of many components. It's not finished
    [iCE40hxk4_dev_board.kicad_pcb]
2017-05-29 Agregado el DAC (MCP4716). Corregida la masa del mux. Asignados algunos footprints.
    [ADC.sch, Attenuation.sch, Offset.sch, PGA.sch, etapa_analogica.sch, powerSupply.sch]
2017-05-29 agregados capas de desacople de ICs
    [Attenuation.sch, etapa_analogica.sch, powerSupply.sch]
2017-05-29 Se conecta la tensión 5V a los conectores (right y left) y se cambia de nombre de un componente MIC2005A-2 -> MIC2005A-2YM5
    [FPGA_PROGRAMMING+POWER.sch, RAM+LEFT_BOTTOM_BANKs.sch, RIGHT_TOP_BANKs.sch, USB+OSCILLATOR+REGULATOR.sch, iCE40hxk4_dev_board.sch]
2017-05-30 Part Number de Capacitores de bypass
    [ADC.sch, Attenuation.sch, Offset.sch, PGA.sch, etapa_analogica.sch, powerSupply.sch]
2017-05-30 Cambiados valores de resistores y capacitores Vref_ADC
    [ADC.sch, Attenuation.sch, Offset.sch, PGA.sch, etapa_analogica.sch, powerSupply.sch]
2017-06-02 pequeños cambios
    [ADC.sch, Offset.sch]
2017-06-02 Solved problem with power distribution.
    [FPGA_PROGRAMMING+POWER.sch, RAM+LEFT_BOTTOM_BANKs.sch, RIGHT_TOP_BANKs.sch, USB+OSCILLATOR+REGULATOR.sch, iCE40hxk4_dev_board.sch]
2017-06-05 Cambiados labels globales por jerárquicos. Agregadas ganancias de yapa en etapa PGA.
    [ADC.sch, Attenuation.sch, Offset.sch, PGA.sch, etapa_analogica.sch, powerSupply.sch]
2017-06-05 Agregados valores de resistencias PGA.
    [PGA.sch]
2017-06-05 corregido error en el mic5270.
    [powerSupply.sch]
2017-06-15 Se chequean y asignan footprints de la power supply
2017-06-15 Faltó agregar los archivos en el commit anterior
    [ADC.sch, Attenuation.sch, Offset.sch, PGA.sch, etapa_analogica.sch, powerSupply.sch]
2017-06-24 Ruteo de la parte digital completo. Falta revision y ordenar el silk
    [iCE40hxk4_dev_board.kicad_pcb]
2017-07-11 Completed part selection of analog board. Merged analog and digital boards.
    [ADC.sch, Analog_Power_Supply.sch, Attenuation.sch, FPGA_PROGRAMMING+POWER.sch, Offset.sch, PGA.sch, RAM+LEFT_BOTTOM_BANKs.sch, RIGHT_TOP_BANKs.sch]
2017-07-11 Footprint config added to analog merge
2017-07-11 No more DRC errors :)
    [ADC.sch, Analog_Power_Supply.sch, Attenuation.sch, FPGA_PROGRAMMING+POWER.sch, Offset.sch, PGA.sch, USB+OSCILLATOR+REGULATOR.sch, etapa_analogica.sch]
2017-07-12 Started final routing ...
    [Offset.sch, PGA.sch, iCE40hxk4_dev_board.kicad_pcb]
2017-07-15 Ended placing (?)
    [ADC.sch, Attenuation.sch, PGA.sch, RIGHT_TOP_BANKs.sch, iCE40hxk4_dev_board.kicad_pcb]
2017-07-15 Continued with routing. It is all connected now, but need a revision, DRC check, etc ...
    [RAM+LEFT_BOTTOM_BANKs.sch, iCE40hxk4_dev_board.kicad_pcb]
2017-08-01 Assignement of FPGA pins for analog stage control
    [ADC.sch, Attenuation.sch, FPGA_PROGRAMMING+POWER.sch, Offset.sch, RAM+LEFT_BOTTOM_BANKs.sch, RIGHT_TOP_BANKs.sch, USB+OSCILLATOR+REGULATOR.sch, etapa_analogica.sch]
2017-08-04 Startin routing the analog side of the force
    [ADC.sch, etapa_analogica.sch, iCE40hxk4_dev_board.kicad_pcb, iCE40hxk4_dev_board.sch]
2017-08-05 Minor changes
    [iCE40hxk4_dev_board.kicad_pcb]
2017-08-15 Almost finish
    [Offset.sch, PGA.sch, iCE40hxk4_dev_board.kicad_pcb, iCE40hxk4_dev_board.sch]
2017-08-15 Changed part number of DAC (different dir). Connected ADC_OE to GND.
    [Offset.sch, iCE40hxk4_dev_board.kicad_pcb, iCE40hxk4_dev_board.sch]
2017-08-15 Added reset button. Delated unused fpga analog control connections. Added this connections to the expansion connector
    [ADC.sch, Analog_Power_Supply.sch, Attenuation.sch, FPGA_PROGRAMMING+POWER.sch, Offset.sch, PGA.sch, RAM+LEFT_BOTTOM_BANKs.sch, RIGHT_TOP_BANKs.sch]
2017-08-15 Added square wave output.
    [ADC.sch, Attenuation.sch, FPGA_PROGRAMMING+POWER.sch, Offset.sch, RIGHT_TOP_BANKs.sch, USB+OSCILLATOR+REGULATOR.sch, iCE40hxk4_dev_board.kicad_pcb, iCE40hxk4_dev_board.sch]
2017-08-22 Modified a lot of fields in components parts. BOM generated. Added BOM plugin script.
    [ADC.sch, Analog_Power_Supply.sch, Attenuation.sch, FPGA_PROGRAMMING+POWER.sch, Offset.sch, PGA.sch, RAM+LEFT_BOTTOM_BANKs.sch, RIGHT_TOP_BANKs.sch]
2017-08-22 Changed some MPN and footprints. BOM updated.
    [ADC.sch, Analog_Power_Supply.sch, Attenuation.sch, FPGA_PROGRAMMING+POWER.sch, Offset.sch, PGA.sch, RAM+LEFT_BOTTOM_BANKs.sch, RIGHT_TOP_BANKs.sch]
2017-08-22 Added Jack and bnc symbols to schematic.
    [ADC.sch, Analog_Power_Supply.sch, Attenuation.sch, FPGA_PROGRAMMING+POWER.sch, Offset.sch, PGA.sch, RAM+LEFT_BOTTOM_BANKs.sch, RIGHT_TOP_BANKs.sch]
2017-08-22 Changed trimmer caps MPN and footprints
    [Attenuation.sch, etapa_analogica.sch, iCE40hxk4_dev_board.csv]
2017-08-23 Moved some capacitors
    [iCE40hxk4_dev_board.kicad_pcb]
2017-08-23 Selected connectors and footprints added.
    [ADC.sch, Attenuation.sch, FPGA_PROGRAMMING+POWER.sch, Offset.sch, USB+OSCILLATOR+REGULATOR.sch, iCE40hxk4_dev_board.sch]
2017-08-23 Added testpoints to schematic.
    [ADC.sch, Analog_Power_Supply.sch, Attenuation.sch, FPGA_PROGRAMMING+POWER.sch, Offset.sch, PGA.sch, RAM+LEFT_BOTTOM_BANKs.sch, USB+OSCILLATOR+REGULATOR.sch]
2017-08-23 Updated BOM and netlist
    [ADC.sch, Analog_Power_Supply.sch, Attenuation.sch, FPGA_PROGRAMMING+POWER.sch, Offset.sch, PGA.sch, USB+OSCILLATOR+REGULATOR.sch, iCE40hxk4_dev_board.csv]
2017-08-24 replaced external dc connector: usb instead of pines. Sí, pines
    [ADC.sch, Analog_Power_Supply.sch, Attenuation.sch, FPGA_PROGRAMMING+POWER.sch, Offset.sch, PGA.sch, RAM+LEFT_BOTTOM_BANKs.sch, RIGHT_TOP_BANKs.sch]
2017-08-24 Updated schematic
    [ADC.sch, Analog_Power_Supply.sch, Attenuation.sch, FPGA_PROGRAMMING+POWER.sch, Offset.sch, PGA.sch, RAM+LEFT_BOTTOM_BANKs.sch, RIGHT_TOP_BANKs.sch]
2017-08-24 Doing re-routing
    [ADC.sch, Attenuation.sch, FPGA_PROGRAMMING+POWER.sch, Offset.sch, USB+OSCILLATOR+REGULATOR.sch, iCE40hxk4_dev_board.kicad_pcb, iCE40hxk4_dev_board.sch]
2017-08-25 Rerouted with trimmer caps corrected footprints
    [iCE40hxk4_dev_board.kicad_pcb]
2017-08-25 Removed 3D of trimmer caps
    [iCE40hxk4_dev_board.kicad_pcb]
2017-08-26 Changed 1/4 jack to 1/8 jack
    [ADC.sch, Analog_Power_Supply.sch, Attenuation.sch, FPGA_PROGRAMMING+POWER.sch, Offset.sch, PGA.sch, RAM+LEFT_BOTTOM_BANKs.sch, RIGHT_TOP_BANKs.sch]
2017-08-28 Changed audio jack in pcb
    [iCE40hxk4_dev_board.kicad_pcb]
2017-08-28 Added resistance to control lines to prevent overshoot
    [ADC.sch, Attenuation.sch, FPGA_PROGRAMMING+POWER.sch, Offset.sch, USB+OSCILLATOR+REGULATOR.sch, etapa_analogica.sch, iCE40hxk4_dev_board.kicad_pcb, iCE40hxk4_dev_board.sch]
2017-08-28 Updated some MPN
    [ADC.sch, Analog_Power_Supply.sch, Attenuation.sch, FPGA_PROGRAMMING+POWER.sch, Offset.sch, PGA.sch, RIGHT_TOP_BANKs.sch, USB+OSCILLATOR+REGULATOR.sch]
2017-08-29 Added BOM generated with kicost
    [iCE40hxk4_dev_board.xlsx]
2017-08-29 Updated kicost BOM
    [iCE40hxk4_dev_board.xlsx]
2017-08-29 Almost rev1
    [ADC.sch, Analog_Power_Supply.sch, Attenuation.sch, FPGA_PROGRAMMING+POWER.sch, Offset.sch, PGA.sch, RAM+LEFT_BOTTOM_BANKs.sch, RIGHT_TOP_BANKs.sch]
2017-08-29 Updated MPN to components avalaible in mouser. Updating footprints now ...
    [ADC.sch, Analog_Power_Supply.sch, Attenuation.sch, FPGA_PROGRAMMING+POWER.sch, Offset.sch, PGA.sch, RAM+LEFT_BOTTOM_BANKs.sch, RIGHT_TOP_BANKs.sch]
2017-08-29 Updated some footprints. Not updated audio jack and BNC.
    [ADC.sch, Analog_Power_Supply.sch, Attenuation.sch, FPGA_PROGRAMMING+POWER.sch, Offset.sch, PGA.sch, RAM+LEFT_BOTTOM_BANKs.sch, RIGHT_TOP_BANKs.sch]
2017-08-30 Updated jack symbol and footprint
    [ADC.sch, Analog_Power_Supply.sch, Attenuation.sch, FPGA_PROGRAMMING+POWER.sch, Offset.sch, PGA.sch, RAM+LEFT_BOTTOM_BANKs.sch, RIGHT_TOP_BANKs.sch]
2017-08-30 Highlighted repeated items in BOM
    [iCE40hxk4_dev_board.xlsx]
2017-08-30 Updated BNC and USB footprints
    [USB+OSCILLATOR+REGULATOR.sch, iCE40hxk4_dev_board.sch]
2017-08-30 Corrected PN in BOM
    [iCE40hxk4_dev_board.xlsx]
2017-08-30 Changed incorrect footprint
    [USB+OSCILLATOR+REGULATOR.sch]
2017-08-30 Changed MPN FT2232H to FT2232HL
    [USB+OSCILLATOR+REGULATOR.sch]
2017-08-30 New BOM generated with kicost
    [ADC.sch, Analog_Power_Supply.sch, Attenuation.sch, FPGA_PROGRAMMING+POWER.sch, Offset.sch, PGA.sch, RAM+LEFT_BOTTOM_BANKs.sch, RIGHT_TOP_BANKs.sch]
2017-08-31 Renamed PN: AS4C1M16S->AS4C1M16S-7TCN; MIC5270->MIC5270-3.0YM5-TR; CLC4007->CLC4007ITP14MTR
    [ADC.sch, Analog_Power_Supply.sch, Attenuation.sch, FPGA_PROGRAMMING+POWER.sch, Offset.sch, PGA.sch, RAM+LEFT_BOTTOM_BANKs.sch, RIGHT_TOP_BANKs.sch]
2017-09-01 Oscillator changed
    [ADC.sch, Analog_Power_Supply.sch, Attenuation.sch, FPGA_PROGRAMMING+POWER.sch, Offset.sch, PGA.sch, RAM+LEFT_BOTTOM_BANKs.sch, RIGHT_TOP_BANKs.sch]
2017-09-01 Corrected digital part of pcb with new footprints of roms and new oscillators
    [iCE40hxk4_dev_board.kicad_pcb, iCE40hxk4_dev_board.sch]
2017-09-03 Corrected routing in analogue part of board
    [iCE40hxk4_dev_board.kicad_pcb, iCE40hxk4_dev_board.sch]
2017-09-05 Fab files
    [ADC.sch, Attenuation.sch, FPGA_PROGRAMMING+POWER.sch, Offset.sch, USB+OSCILLATOR+REGULATOR.sch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]
2017-10-11 New analog front end started. Trying to solve routing in one layer ...
    [analog_board.kicad_pcb, analog_board.sch]
2017-10-17 Finished with routing.
    [analog_board.kicad_pcb, analog_board.sch]
2017-10-17 Modified fcu gnd plane
    [analog_board.kicad_pcb]
2017-11-14 New version of mainboard. Corrected errors and modified analog part.
    [ADC.sch, Analog_Power_Supply.sch, Attenuation.sch, FPGA_PROGRAMMING+POWER.sch, Offset.sch, PGA.sch, USB+OSCILLATOR+REGULATOR.sch, analog_board.kicad_pcb]
2017-11-14 Reverted changes in PGA and attenuation
    [Attenuation.sch, PGA.sch]
2017-11-14 Corrected PCB
    [Attenuation.sch, PGA.sch, iCE40hxk4_dev_board.kicad_pcb]
2017-11-25 Added pdf with gerbers
2017-11-25 no copper in holes, labels to indicate front and bottom
    [analog_board.kicad_pcb]
